PJayChen/Crazyflies/4x_app_crazyflie_rel_a/release_note.JPG

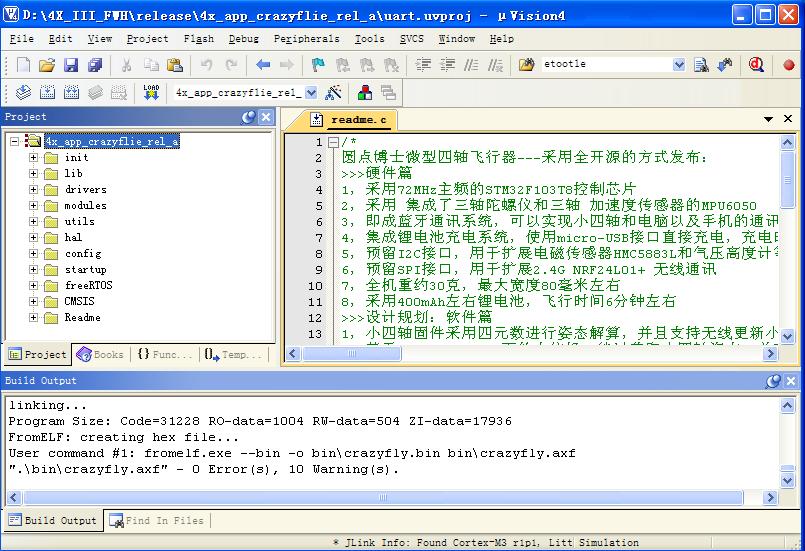
4x_app_crazyflie_rel_a/release_note.JPG
