PJayChen/Crazyflies/4x_menue_v30.pdf

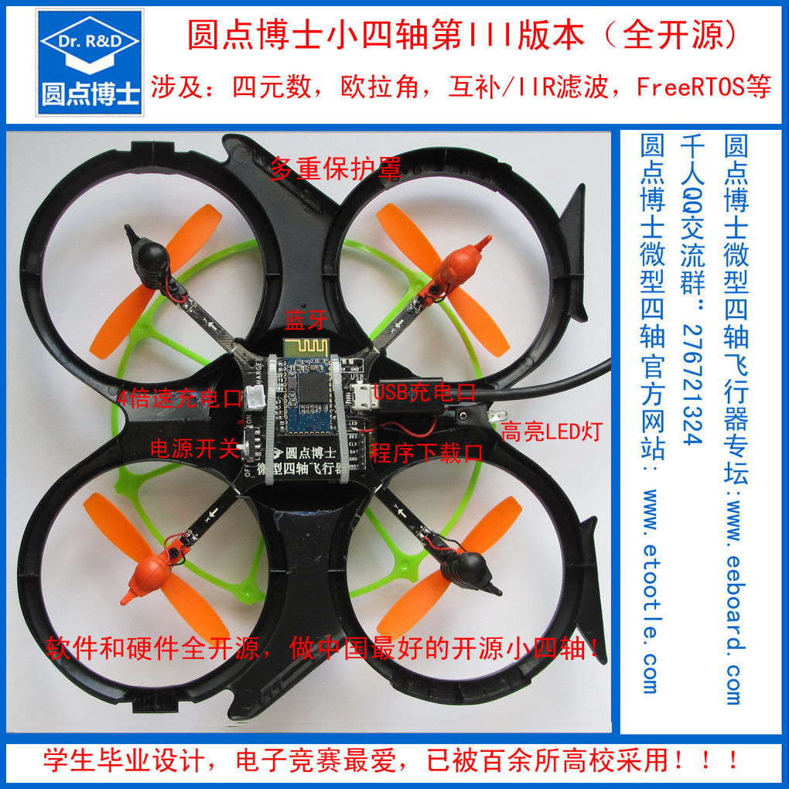
[picture p2: figure]

圆点博士微型四轴飞行器 www.etootle.com

## 圆点博士微型四轴飞行器第III版本使用手册

初版3.11
2013年8月14日发布

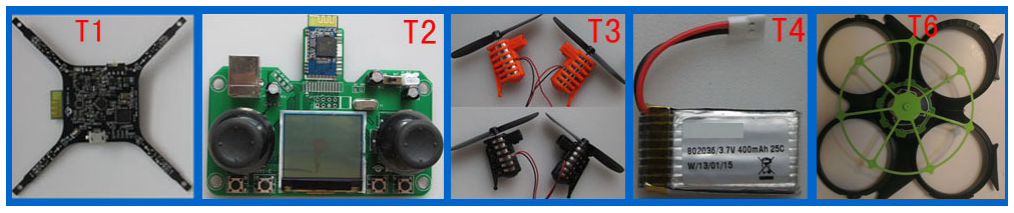
[picture p3: figure]

圆点博士微型四轴飞行器 www.etootle.com

圆点博士微型四轴飞行器第III版：

>>>硬件篇
1，采用了72MHz主频的STM32F103T8控制芯片 2，采用了三轴陀螺仪和三轴加速度传感器的MPU6050 3，集成蓝牙通讯系统，可以实现小四轴和电脑/手机的通讯 4，集成锂电池充电系统，可以使用micro-USB接口直接充电 5，预留电磁传感器HMC5883L芯片安装位置，方便用户进行扩展 6，预留I2C接口，用于扩展电磁传感器HMC5883L和高度计BMP085等模块 7，预留SPI接口，用于扩展2.4G NRF24L01+ 无线通讯模块 8，全机重约45克，对角电机中心点宽度120毫米左右 9，采用400mAh左右锂电池，飞行时间6分钟左右

>>>软件篇
1，小四轴固件采用四元数进行姿态解算的源码，支持无线更新固件 2，基于MPU6050 DMP的姿态解算源码
3，基于国外开源软件Crazyflie姿态解算源码的部分移植 4，基于windows/Linux下的上位机，能够控制小四轴飞行 5，基于Android的上位机，可以实现对小四轴的飞行控制 6，基于labview的部分上位机编程，实现波形显示

>>>开源说明：
1，PDF格式原理图和元器件列表
2，小四轴固件全部源码
3，PC上位机全部源码
4, Android的上位机全部源码

圆点博士微型四轴飞行器 www.etootle.com

目录：

第I部分：小四轴
第1.1节：圆点博士微型四轴飞行器的蓝牙连接
第1.2节：圆点博士微型四轴飞行器电机的组装
第1.3节：圆点博士微型四轴飞行器电池的组装
第1.4节：圆点博士微型四轴飞行器的外部模块(HMC5883L/BMP085)连接 第1.5节：圆点博士微型四轴飞行器飞行测试
第1.6节：圆点博士微型四轴飞行器固件更新
第1.7节：圆点博士微型四轴飞行器PID调节方法
第1.8节：圆点博士微型四轴飞行器使用注意事项

第II部分：手持遥控器
第2.1节：圆点博士微型四轴飞行器手持遥控器电源选择开关 第2.2节：圆点博士微型四轴飞行器手持遥控器固件更新 第2.3节：圆点博士微型四轴飞行器手持遥控器连接小四轴

第III部分：源码编译环境和说明
请参考视频教程

第IV部分：飞行理论
请参看论文部分

第V部分：附录
附录1：圆点博士微型四轴飞行器电路图
附录2：圆点博士微型四轴手持遥控器电路图
附录3：圆点博士微型四轴第III版元器件列表
附录4：圆点博士微型四轴蓝牙模块指令说明
附录5：圆点博士资料链接和版权声明

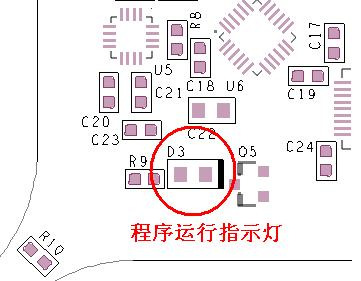
[picture p4: figure]
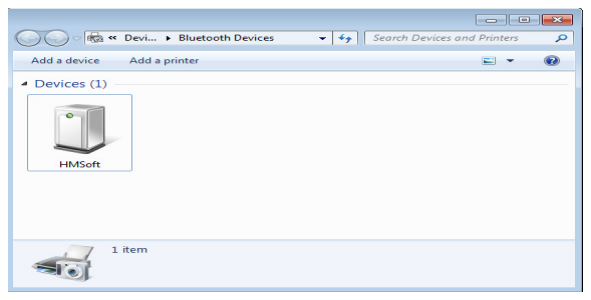
[picture p5: figure]
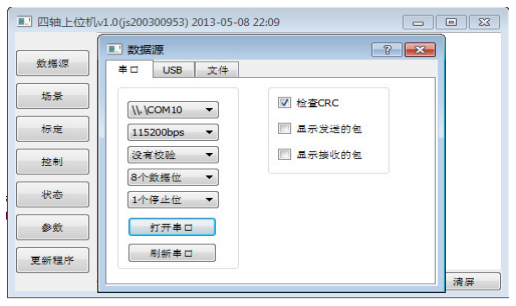
[picture p6: figure]
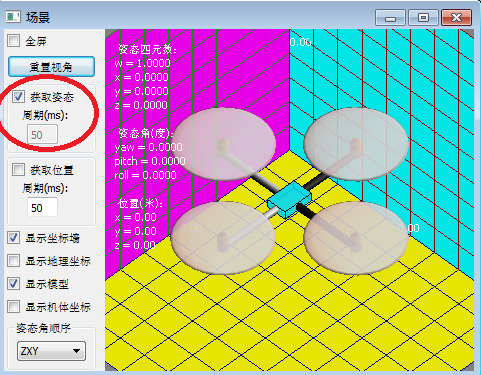
[picture p7: figure]

圆点博士微型四轴飞行器 www.etootle.com

第1.1节：圆点博士微型四轴飞行器的蓝牙连接

蓝牙连接步骤：
1， 打开小四轴的开关，此时小
四轴上的程序运行指示灯会
以每秒一次的速度进行闪
烁。
2， 打开PC的蓝牙开关，并添加
新的蓝牙设备。蓝牙配置密
码是数字“1234”
3， 配对成功后，连接蓝牙，并
找到蓝牙的映射端口
4， 打开小四轴上位机，选择数
据源，并选择对应的COM口
（也可手动输入COM口）.
5， 打开COM口成功后，即可以在
状态栏查看锂电池电压，和
在场景栏看到小四轴姿势。

注意：
1．进行该测试的时候，用户也可以
不装锂电池，而仅仅通过USB线给小
四轴通电。

2．在场景测试下，即使小四轴静止
不动，可能也能观察到小四轴的缓慢
围绕轴心转动。这是由于yaw的飘动
引起的，属于正常现象。对陀螺仪进
行校正可以缩小yaw的偏移。

### 3. 当使用蓝牙把小四轴连接到PC蓝

牙的时候，注意不要用电池等物品遮
挡住小四轴上的蓝牙天线，也不要把
身体或者其它物品放置在PC蓝牙天线
发射点和小四轴之间，否则会引起蓝
牙信号不佳的问题。

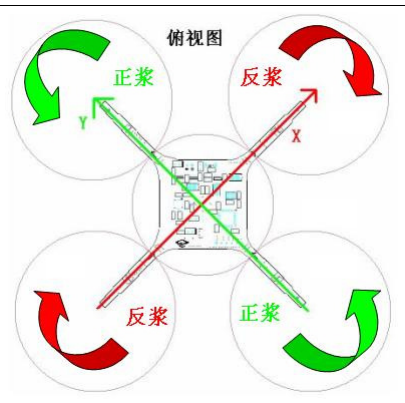
[picture p8: figure]
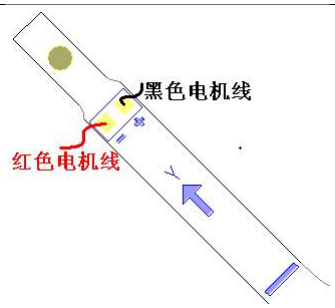
[picture p9: figure]
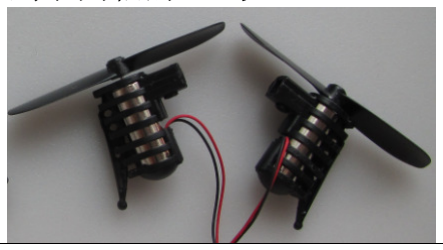
[picture p10: figure]
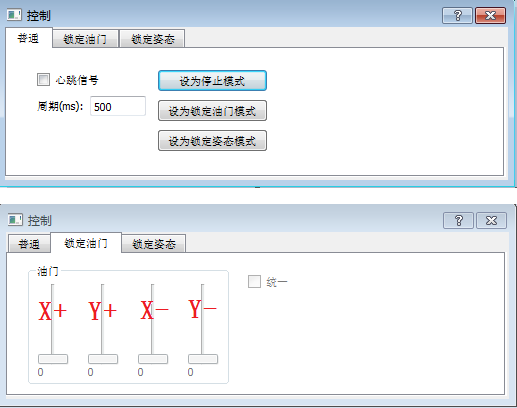
[picture p11: figure]

圆点博士微型四轴飞行器 www.etootle.com

第1.2节：圆点博士微型四轴飞行器电机的组装（只有T1套件需要进行电 机组装，对于T1+T3套件，电机已经组装好，用户无需自行组装）：

步骤一：选定电机位置 电机浆分为正浆和反浆。在俯视情 况下，顺时针旋转浆，如果浆是从 低平面向高平面方向旋转，则为反 浆；如果浆是从高平面向低平面方 向旋转，则为正浆。

步骤二：焊接电机线 把所搭配的电机的红色电线连接到 小四轴的”-”号上，黑色电线连接 到小四轴的”+”号上。

步骤三：测试电机 1． 打开上位机 2． 设置为锁定油门模式 3． 用鼠标拉动油门值 测试中，请检查是否每个电机都是 朝地面吹风。如果发生朝上面吹风 的现象，请检查浆的安装，或者电 机电线的焊接。四个油门分别对应 小四轴上X+, Y+, X-, Y-的电机。 注：上述测试需要在小四轴和上位 机已经连接的情况下进行，并且需 要安装上电池。

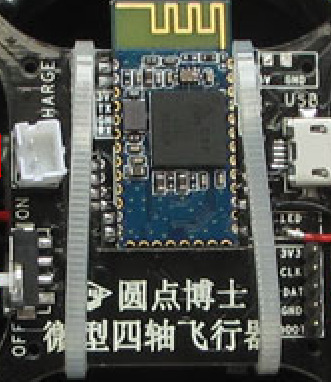
[picture p12: figure]
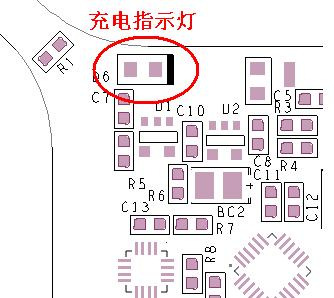
[picture p13: figure]

圆点博士微型四轴飞行器 www.etootle.com

第1.3节：圆点博士微型四轴飞行器电池的组装：

组装步骤：
1． 用双面贴固定电池
并安装到正面。
2． 捆上塑料条固定整
个电池，建议按照
图示方向安装塑料
条。
3． 连接电池接口，红
线和红线连接。小
四轴上有防反插接
口，请勿反插电
池。
4． 注意：请勿让电池
阻挡蓝牙天线

小四轴已经集成锂电池充电
系统。把USB头通过USB线连
接到电脑的USB口，或者带
USB口的电源适配器，小四轴
即开始对锂电池进行充电。
1． 充电过程中，充电
指示灯会亮起，充
电完成后，指示灯
会熄灭。
2． 如果充电指示灯以
微弱的亮度在闪
烁，则表明锂电池
没有连接好。
3． 开关的打开或者闭
合不影响充电过
程。

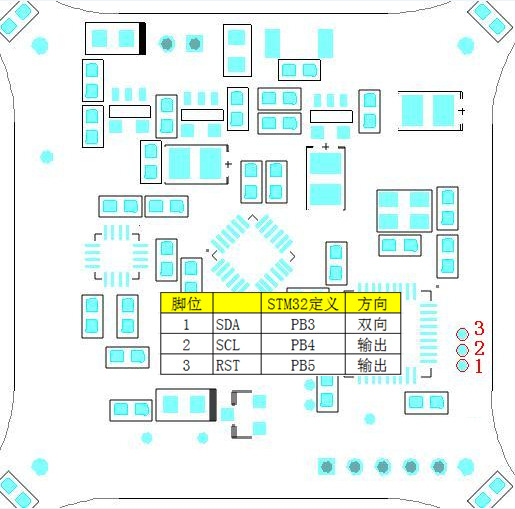
[picture p14: figure]

圆点博士微型四轴飞行器 www.etootle.com

第1.4节：圆点博士微型四轴飞行器的外部模块连接（可选，仅针对有需 要的用户）。

外接I2C接口, 可以用作普通I2C接口或者普通GPIO。用户可以通过该接口 连接磁场传感器HMC5883L模块和气压计模块BMP085。 注意：当连接I2C模块时，用户需要确保模块的SDA引脚上有上拉电阻。

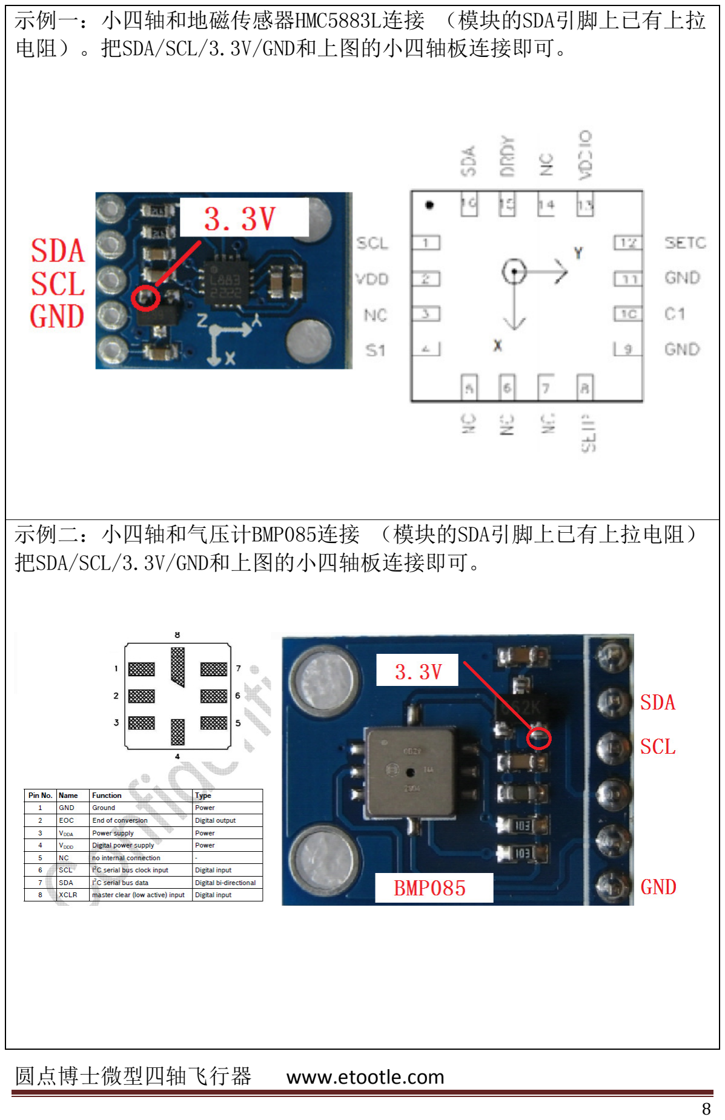
[picture p15: page 8]

圆点博士微型四轴飞行器 www.etootle.com

示例一：小四轴和地磁传感器HMC5883L连接 （模块的SDA引脚上已有上拉 电阻）。把SDA/SCL/3.3V/GND和上图的小四轴板连接即可。

示例二：小四轴和气压计BMP085连接 （模块的SDA引脚上已有上拉电阻） 把SDA/SCL/3.3V/GND和上图的小四轴板连接即可。

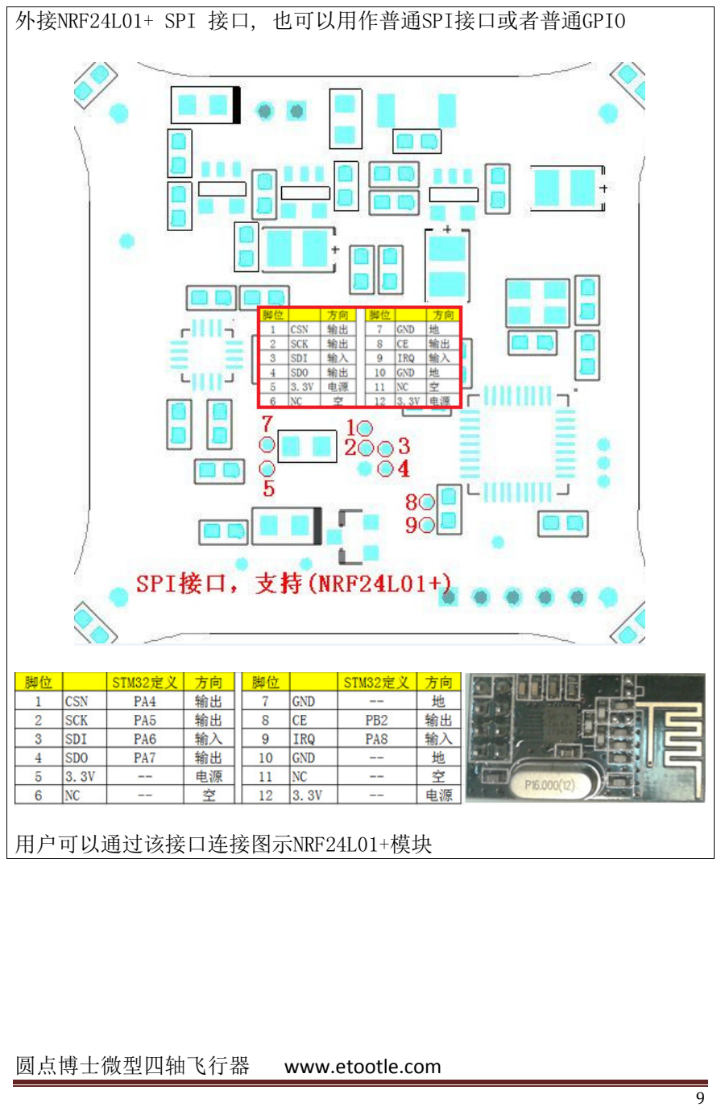
[picture p16: page 9]

圆点博士微型四轴飞行器 www.etootle.com

外接NRF24L01+ SPI 接口, 也可以用作普通SPI接口或者普通GPIO

用户可以通过该接口连接图示NRF24L01+模块

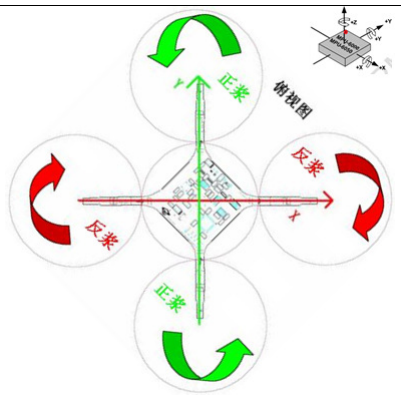
[picture p17: figure]
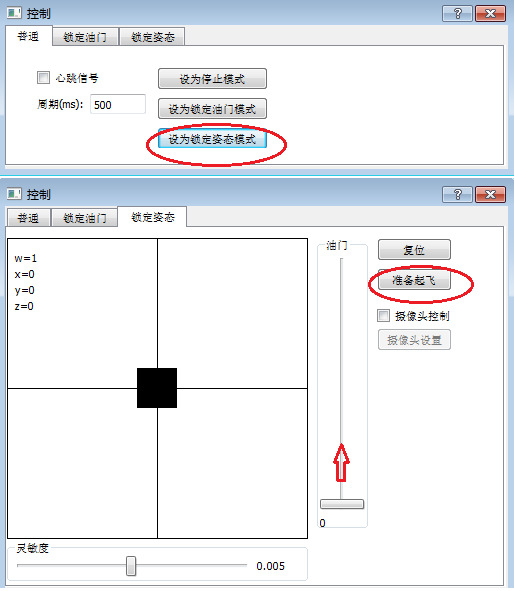
[picture p18: figure]
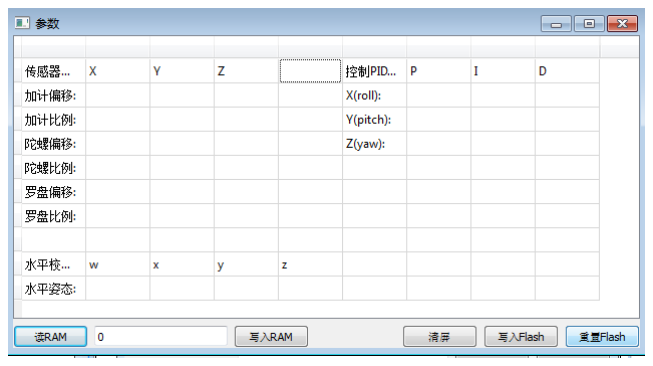
[picture p19: figure]

圆点博士微型四轴飞行器 www.etootle.com

第1.5节：圆点博士微型四轴飞行器飞行测试

1， 把小四轴按照左图所示方向
放置，以对应于上位机的方
向控制。
2， 在上位机设置模式为“锁定
姿势模式”。
3， 在姿势界面点击“准备起
飞”。
4， 轻轻拉动油门。
5， 根据小四轴起飞后的偏移方
向微调小黑块位置，反复调
试，即可获得较佳的起飞角
度。
6， 小四轴起飞后，可通过调整
小黑块来实现飞行方向的控
制
7， 用户也可以通过调整PID参数
来获得更好的飞行和悬浮稳
定性。

注意：小四轴代码集成了电机保护和
电池保护功能：
1． 如果小四轴机身倾斜超过一
定角度，电机会被锁死。此
时，用户需要到“控制界
面”重新设定模式为锁定姿
势模式”。
2． 如果电池电压过低，电机也
会停止运转，此时用户应该
对电池进行充电。

当用户发现电机无法转动的时候，请
根据上位机主界面的提示排除上述情
况。

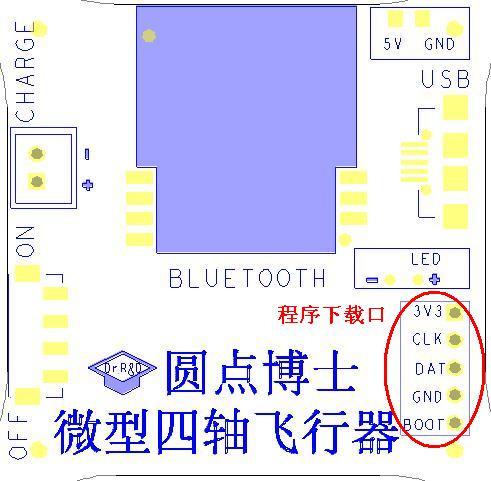
[picture p20: figure]

圆点博士微型四轴飞行器 www.etootle.com

第1.6节：圆点博士微型四轴飞行器固件更新

警告：在使用SWD下载的时候，请勿把3.3V
和GND反接。反接会引起小四轴的永久损
坏。如非必要，请勿使用SWD方式下载固
件。

小四轴在出厂前已经预装好
固件。用户可以通过上位机
以无线的方式来更新固件。

注意：如果你对STM32 SWD不
熟悉，请勿匆忙使用该接口
下载固件。建议总是通过上
位机以无线的方式更新固
件。

当一个不正确的固件被通过
上位机以无线的方式更新到
小四轴后，可能到导致你无
法再通过上位机无线更新固
件。在这种情况下，请使用
镊子或者电线短接左图中的
BOOT脚和GND脚，然后给小四
轴上电。此时小四轴将会一
直停留在bootloader状态，
等待用户从上位机通过无线
更新固件。当小四停留在
Bootloader状态下时，只有
更新固件部分可以使用，其
它姿态和电压显示等均无法
使用。当完成固件更新后，
如果小四上的LED灯不闪烁，
建议给小四重新上电，即先
关闭开关，然后再打开开
关。

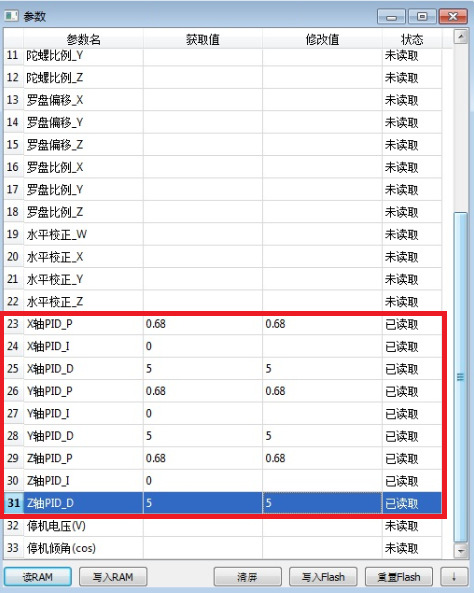
[picture p21: figure]
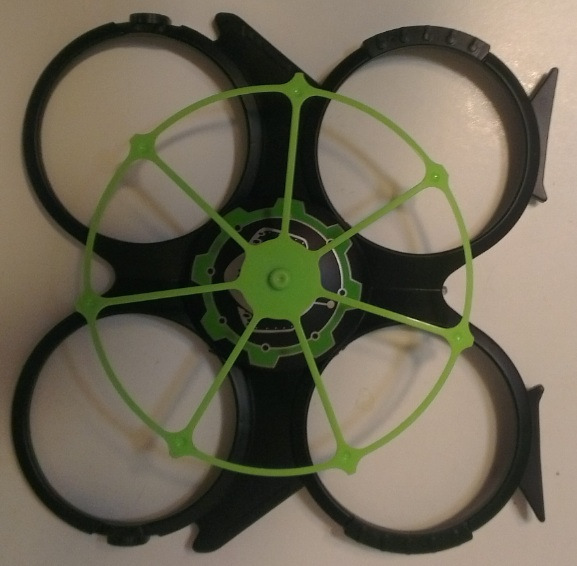
[picture p22: figure]

圆点博士微型四轴飞行器 www.etootle.com

第1.7节：圆点博士微型四轴飞行器PID调节方法
为了获取最佳的飞行参
数，用户可能需要自行
调整小四轴的PID参数。
用户可以根据下面的步
骤方便地进行小四轴的
PID参数调节：

第一步：连接小四轴和
上位机

第二步： 点击“读RAM”
获取小四轴当前的PID参
数

第三步：在“修改值”
栏填入新的PID参数

第四步：点击“写入
RAM”把参数写入小四轴

第五步：到上位机的控
制界面进行飞行测试

第六步：反复上述步
骤，直至找到合适的PID
参数为止。

第七步：点击“写入
Flash”把上述参数写入
小四轴的Flash.

注意：在PID参数的调节
过程中，要注意保护好
小四轴，避免摔坏。可
参考左图给小四轴进行
保护。

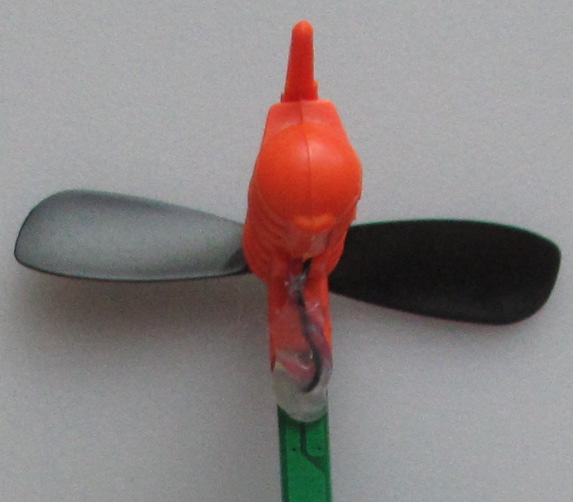
[picture p23: figure]

圆点博士微型四轴飞行器 www.etootle.com

第1.8节：圆点博士微型四轴飞行器使用注意事项

1．注意避免小四轴以左图的方式掉到地
上。 巨大的冲击力可能会把电机后盖顶
开，导致电机损坏。建议在小四正面固定
合适的泡沫，用于保护电机。

2， 每次起飞前，检查电机。如果电机后
盖已经脱落，请勿继续飞行。损坏的电机
可能会导致驱动电路损坏，并起火。

注意：用户需要要小心使用并熟悉套件 。
电机是最容易损坏的部件，请务必小心。

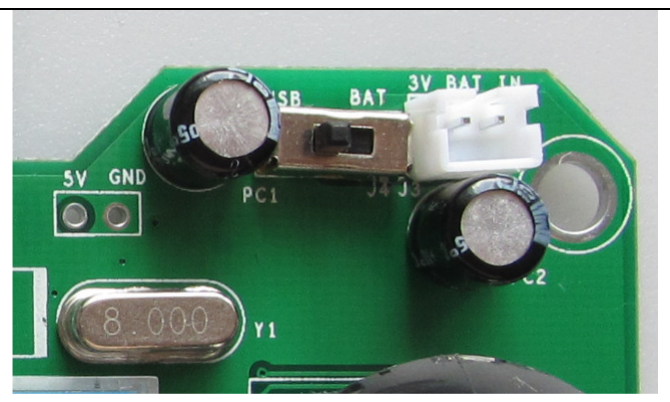
[picture p24: figure]
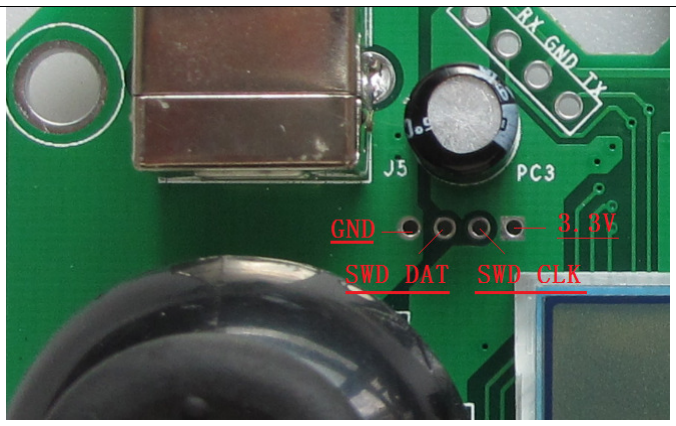
[picture p25: figure]

圆点博士微型四轴飞行器 www.etootle.com

第2.1节：圆点博士微型四轴飞行器手持遥控器电源选择开关

1． 当使用USB供电的时候，需要把开
关拨至”USB”位置。
2． 当使用干电池供电的时候，需要把
开关拨至“BAT”位置。

注意：当使用电池供电的时候，电池输入必
须是3V到3.3V。用户可使用2节干电池串
连。请勿直接使用锂电池提供电源，因为锂
电池的电压是3.7V到4.2V，该电压可能会损
坏该手持遥控器。

第2.2节：圆点博士微型四轴飞行器手持遥控器固件更新

遥控器在出厂前已经预
装好固件。目前，遥控
器并不支持通过上位机
更新固件，只能使用
SWD来进行固件更新。

警告：在使用SWD下载
的时候，请勿把3.3V和
GND反接。反接会引起
遥控器的永久损坏。

第2.3节：圆点博士微型四轴飞行器手持遥控器连接小四轴

给小四轴和手持上电，进入手持的飞行菜单，看是否能看到小四轴上 的电压值，如能看到，则表明连接成功，如不能，请执行下面步骤： 第一步：进入手持遥控器的蓝牙菜单
第二步：选择“Clear”清除
第三步：重新给手持遥控器上电，手持即开始自动寻找并连接小四轴。

注意：由于小四轴的蓝牙同一时间只能和一个蓝牙主设备连接，当进行手 持遥控器连接时，必须断开小四轴和PC蓝牙的连接。

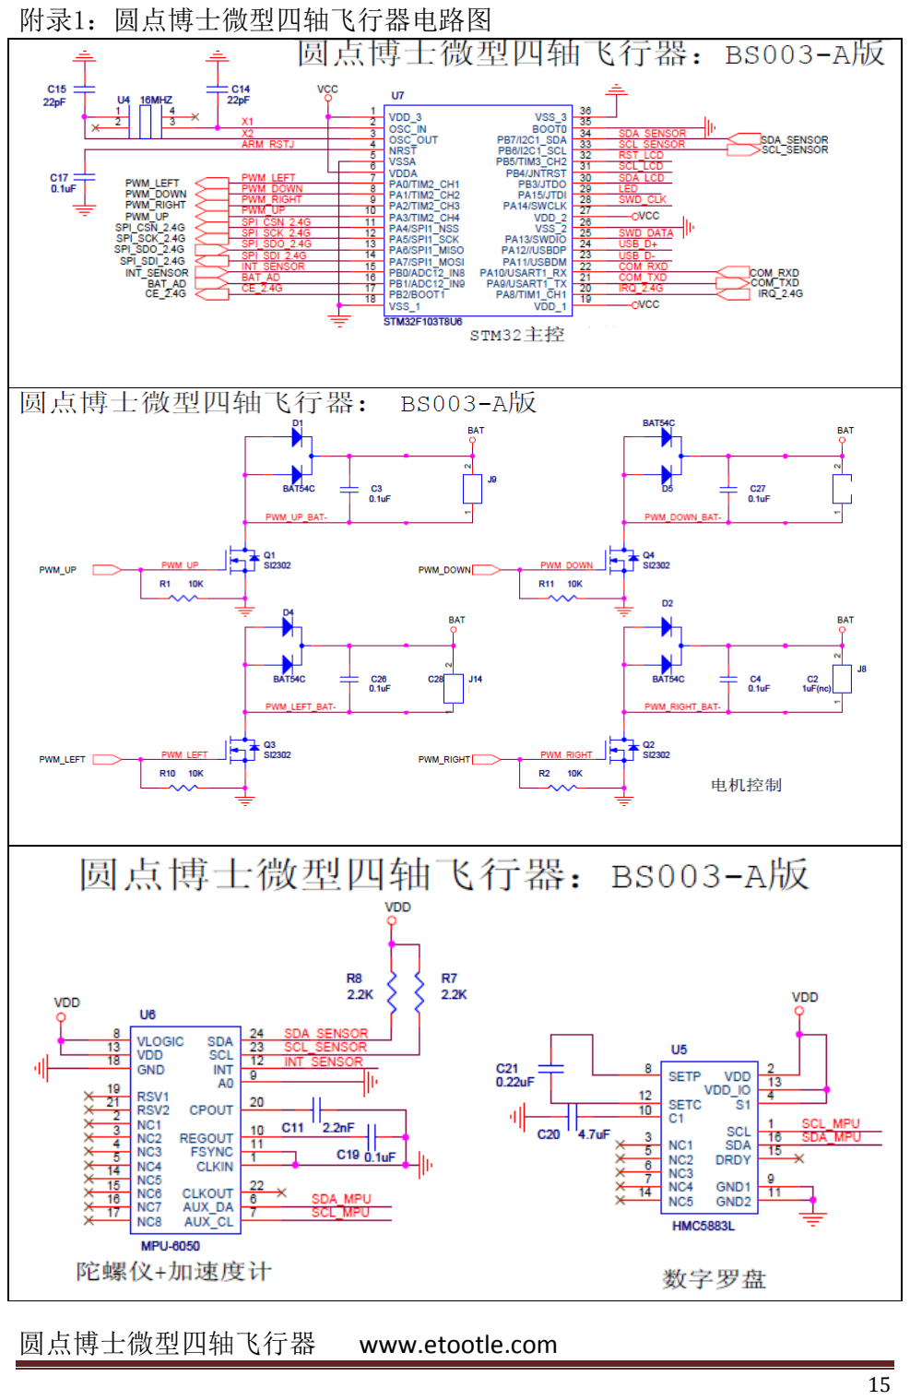
[picture p26: page 15]

圆点博士微型四轴飞行器 www.etootle.com

附录1：圆点博士微型四轴飞行器电路图

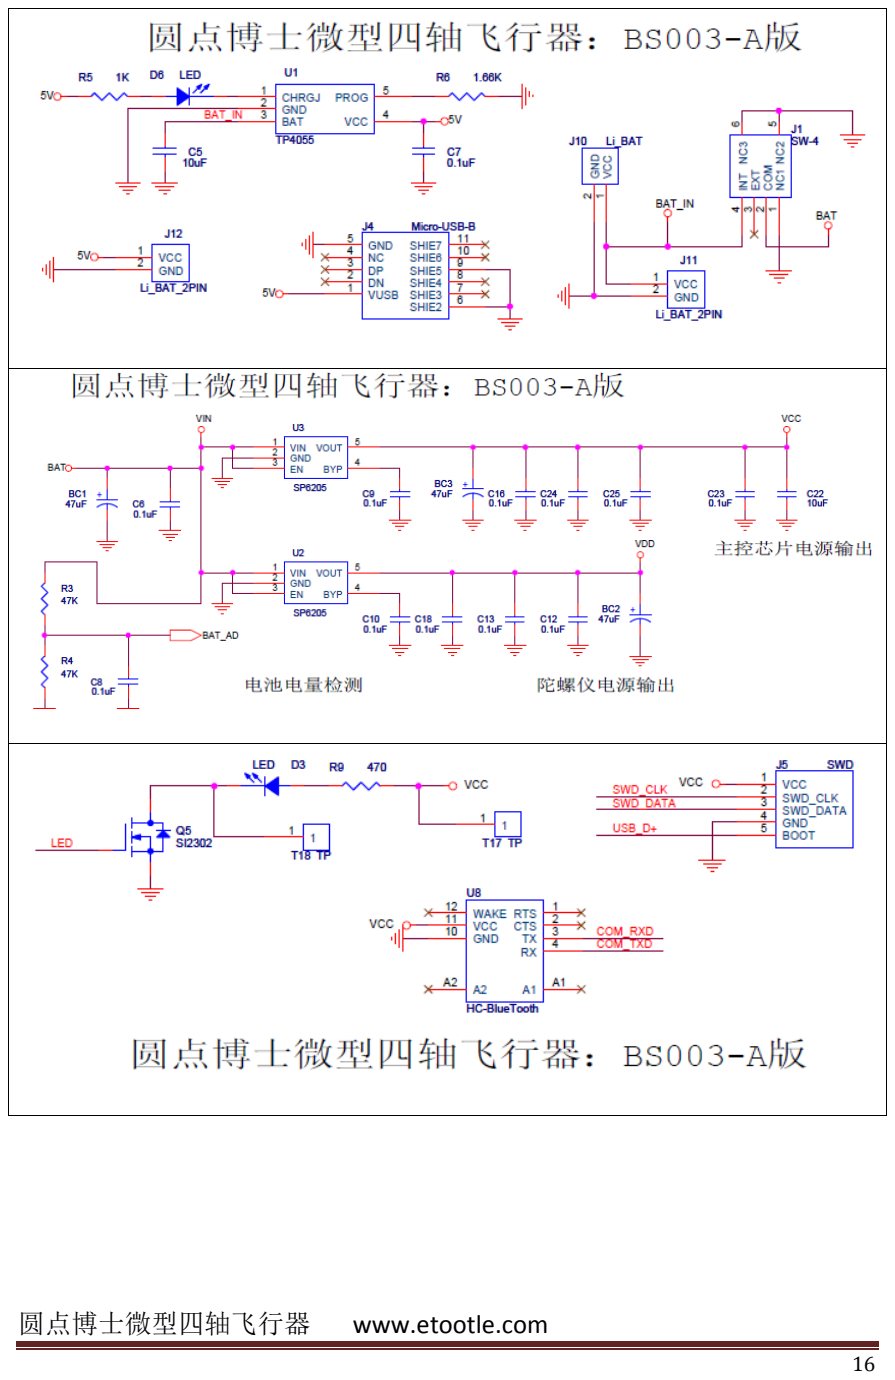
[picture p27: page 16]

圆点博士微型四轴飞行器 www.etootle.com

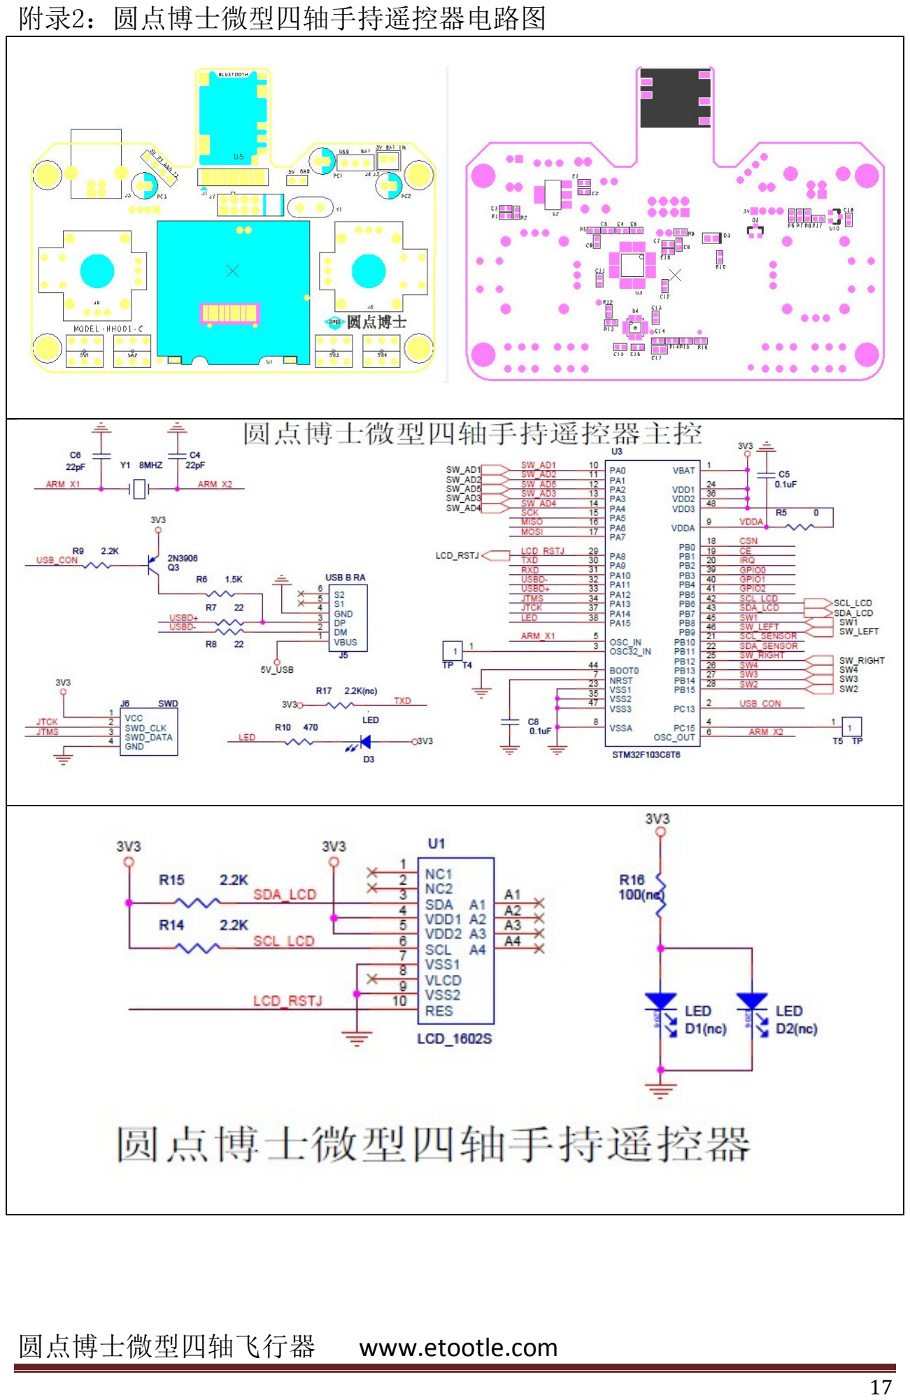
[picture p28: page 17]

圆点博士微型四轴飞行器 www.etootle.com

附录2：圆点博士微型四轴手持遥控器电路图

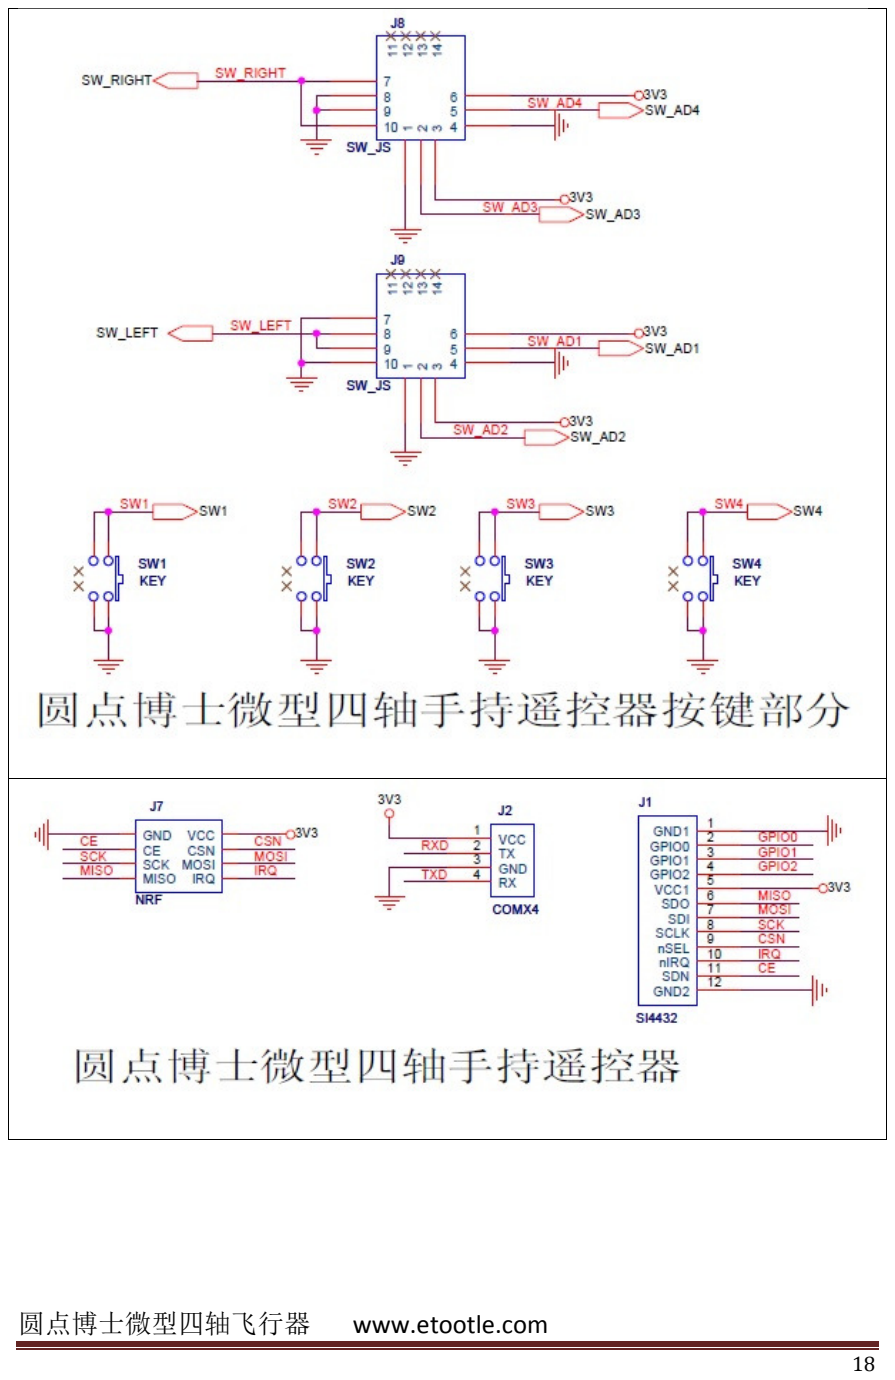
[picture p29: page 18]

圆点博士微型四轴飞行器 www.etootle.com

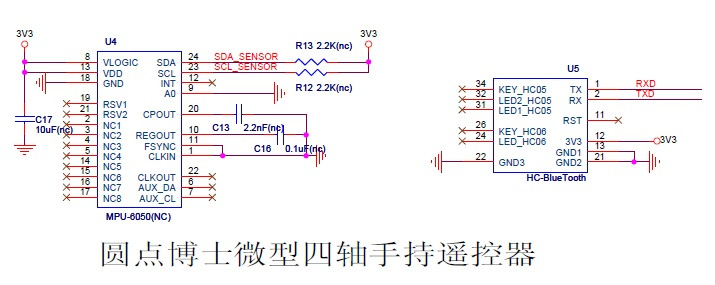
[picture p30: figure]
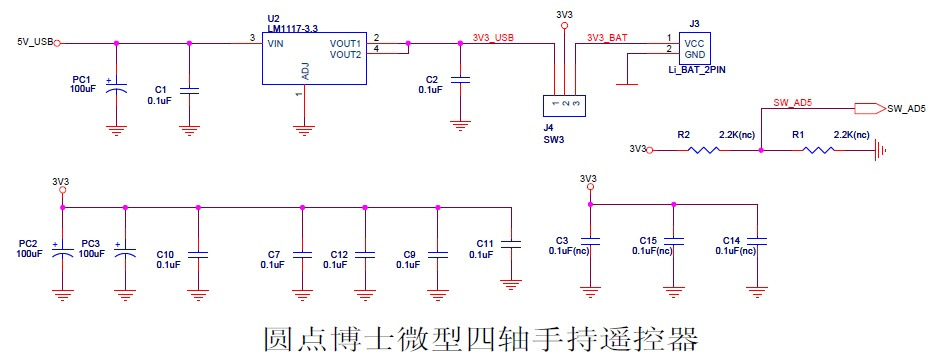
[picture p31: figure]

圆点博士微型四轴飞行器 www.etootle.com

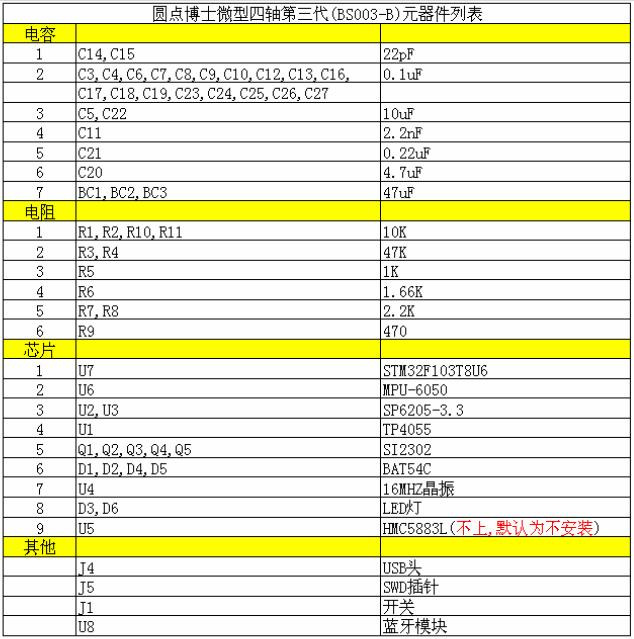
[picture p32: figure]

圆点博士微型四轴飞行器 www.etootle.com

附录3：圆点博士微型四轴第III版元器件列表

圆点博士微型四轴飞行器 www.etootle.com

附录4：圆点博士微型四轴蓝牙模块指令说明

功能 | 指令 | 应答 | 参数和注释
设置主从模式 | AT+ROLE[par] | OK+Set:[par] | Par：M(主)或S(从)
设置配对密码 | AT+PIN[par] | OK+Set:[par] | Par：密码(默认：1234)
清除配对信息 | AT+CLEAR | OK+CLEAR | 清除上次连接的设备
搜索并连接从设备 | AT+SEARCH | OK | 连接新的设备
连接原来的从设备 | AT+CONLAST | OK | 连接上一次连接过的设备
连接指定的从设备 | AT+CONN[par] | OK | Par：蓝牙地址码
设置尝试连接时间 | AT+TCON[par] | OK+Set:[par] | Par:0000-9999(0表示持续)
查询本机MAC地址 | AT+LADD? | OK+LADD: 地址 | 无
设置上电模式 | AT+IMME[par] | OK+Set:[par] | Par：0(等待) 或1(工作)
进入工作模式 | AT+WORK | OK+WORK | 当上电模式为等待时适用
复位模块 | AT+RESTART | OK+RESTART | 无
恢复默认设置 | AT+DEFAULT | OK+DEFAULT | 无
设置设备名称 | AT+NAME[par] | OK+Set[par] | Par：设备名称
设置波特率 | AT+BAUD[par] | OK+Set:[波特率] | Par:1-C 对应:1200-1382400
查询波特率 | AT+BAUD? | OK+BAUD:[par] | Par: 波特率
设置串口校验 | AT+CHK[par | OK+Set:[par] | Par:0(无), 1(ODD), 2(ENEN)
设置停止位宽度 | AT+STOP[par] | OK+Set:[par] | Par:1(一位), 2(两位),
通讯测试 | AT | OK | 无
系统帮助 | AT+HELP? | 帮助信息 | 无

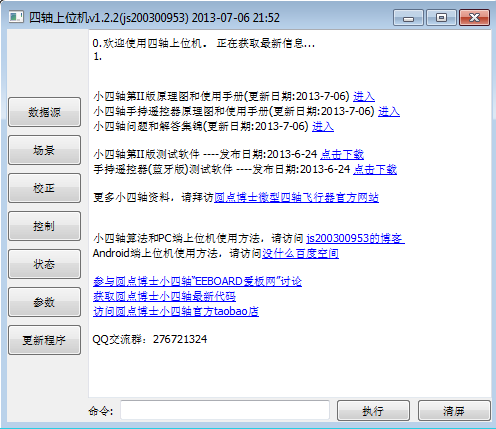
[picture p33: figure]

圆点博士微型四轴飞行器 www.etootle.com

附录5：圆点博士资料链接和版权声明

# 请总是通过打开“PC上位机软件”获取最新的源码和资料 ”获取最新的源码和资料。要获得这些更新信息 。要获得这些更新信息，需 要在有网络连接的情况下打开“PC上位机软件”。

请拜访圆点博士微型四轴飞行器官方网站获得上位机软件： http://www.etootle.com/product/flight-kit.html

请拜访圆点博士微型四轴飞行器专坛查看常见问题和解决方法： http://www.eeboard.com/bbs/forum-98-1.html

欢迎加入圆点博士微型四轴飞行器QQ讨论群（群号：276721324） 参与小 四轴技术讨论。

圆点博士微型四轴飞行器 www.etootle.com

圆点博士微四轴飞行器版权和声明 圆点博士微四轴飞行器版权和声明

感谢大家阅读该使用手册：
圆点博士微型四轴飞行器使用手册仅为使用者提供参考，而圆点博 士不对该使用手册提供任何明示或暗含的担保。圆点博士不对在使用该使 用手册中可 能出现的意外或者损失负责，也不对因使用该使用手册而引 起的第三方索赔负 责。该使用手册内容有可能会被随时变更，相关信息 的更新恕不另行通知。
该使用手册仅以学习的形式发布，并受版权保护, 未经书面授权, 请勿以商业的目的使用或者修改该使用手册。圆点博士对该使用手保留最 终解释权。

该使用手册和相关的文件在官网提供下栽，请随时拜访官网 www.etootle.com获得最新的版本．
