PJayChen/Crazyflies/4x_app_crazyflie_rel_a/init/main.c

/**
 *    ||          ____  _ __                           
 * +------+      / __ )(_) /_______________ _____  ___ 
 * | 0xBC |     / __  / / __/ ___/ ___/ __ `/_  / / _ \
 * +------+    / /_/ / / /_/ /__/ /  / /_/ / / /_/  __/
 *  ||  ||    /_____/_/\__/\___/_/   \__,_/ /___/\___/
 *
 * Crazyflie control firmware
 *
 * Copyright (C) 2011-2012 Bitcraze AB
 *
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
 * main.c - Containing the main function.
 */

/* Personal configs */
#include "FreeRTOSConfig.h"

/* FreeRtos includes */
#include "FreeRTOS.h"
#include "task.h"

/* Project includes */
#include "config.h"
#include "system.h"
#include "nvic.h"

#include "led.h"

/* ST includes */
#include "stm32f10x.h"

/* Private functions */
static void prvClockInit(void);

int main() 
{
  //Low level init: Clock and Interrupt controller
  prvClockInit();
	
  nvicInit();

  //Launch the system task that will initialize and start everything
  systemLaunch();

  //Start the FreeRTOS scheduler
  vTaskStartScheduler();

  //Should never reach this point!
  while(1);

 // return 0;
}

//Clock configuration
static void prvClockInit(void)
{
  ErrorStatus HSEStartUpStatus;

  RCC_DeInit();
  /* Enable HSE */
  RCC_HSEConfig(RCC_HSE_ON);
  /* Wait till HSE is ready */
  HSEStartUpStatus = RCC_WaitForHSEStartUp();

	if (HSEStartUpStatus == SUCCESS)
  {
    /* Enable Prefetch Buffer */
    FLASH_PrefetchBufferCmd(FLASH_PrefetchBuffer_Enable);

    /* Flash 2 wait state */
    FLASH_SetLatency(FLASH_Latency_2);

    /* HCLK = SYSCLK */
    RCC_HCLKConfig(RCC_SYSCLK_Div1);

    /* PCLK2 = HCLK */
    RCC_PCLK2Config(RCC_HCLK_Div1);

    /* PCLK1 = HCLK/2 */
    RCC_PCLK1Config(RCC_HCLK_Div2);

    /* ADCCLK = PCLK2/6 = 72 / 6 = 12 MHz*/
    RCC_ADCCLKConfig(RCC_PCLK2_Div6);

    /* PLLCLK = 16MHz/2 * 9 = 72 MHz */
    RCC_PLLConfig(RCC_PLLSource_HSE_Div2, RCC_PLLMul_9);

    /* Enable PLL */
    RCC_PLLCmd(ENABLE);

    /* Wait till PLL is ready */
    while (RCC_GetFlagStatus(RCC_FLAG_PLLRDY) == RESET);

    /* Select PLL as system clock source */
    RCC_SYSCLKConfig(RCC_SYSCLKSource_PLLCLK);

    /* Wait till PLL is used as system clock source */
    while(RCC_GetSYSCLKSource() != 0x08);
  } else {
      GPIO_InitTypeDef GPIO_InitStructure;
  
    //Cannot start the main oscillator: red/green LED of death...
    GPIO_InitStructure.GPIO_Pin = LED_GPIO_RED | LED_GPIO_GREEN;
    GPIO_InitStructure.GPIO_Mode = GPIO_Mode_Out_PP;
    GPIO_InitStructure.GPIO_Speed = GPIO_Speed_10MHz;

    GPIO_Init(GPIOA, &GPIO_InitStructure);
    
    GPIO_ResetBits(GPIOA, LED_RED);
    GPIO_ResetBits(GPIOA, LED_GREEN);

    //Cannot start xtal oscillator!
    while(1); 
  }
}
