PJayChen/Crazyflies/4x_app_crazyflie_rel_a/drivers/interface/motors.h

/**
 *    ||          ____  _ __                           
 * +------+      / __ )(_) /_______________ _____  ___ 
 * | 0xBC |     / __  / / __/ ___/ ___/ __ `/_  / / _ \
 * +------+    / /_/ / / /_/ /__/ /  / /_/ / / /_/  __/
 *  ||  ||    /_____/_/\__/\___/_/   \__,_/ /___/\___/
 *
 * Crazyflie control firmware
 *
 * Copyright (C) 2011-2012 Bitcraze AB
 *
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
 * Motors.h - Motor driver header file
 *
 * The motors PWM ratio is a value on 16 bits (from 0 to 0xFFFF)
 * the functions of the driver will make the conversions to the actual PWM
 * precision (ie. if the precision is 8bits 0xFFFF and 0xFF00 are equivalents).
 *
 * The precision is set in number of bits by the define MOTORS_PWM_BITS
 * The timer prescaler is set by MOTORS_PWM_PRESCALE
 */
#ifndef __MOTORS_H__
#define __MOTORS_H__

#include <stdint.h>
#include <stdbool.h>
#include "config.h"

/******** Defines ********/

//The following defines gives a PWM of 9 bits at ~140KHz for a sysclock of 72MHz
#define MOTORS_PWM_BITS     9
#define MOTORS_PWM_PERIOD   ((1<<MOTORS_PWM_BITS) - 1)
#define MOTORS_PWM_PRESCALE 0


// Motors IDs define
#define MOTOR_M1  0
#define MOTOR_M2  1
#define MOTOR_M3  2
#define MOTOR_M4  3

// Test defines
#define MOTORS_TEST_RATIO         (uint16_t)(0.5*(1<<16))
#define MOTORS_TEST_ON_TIME_MS    10
#define MOTORS_TEST_DELAY_TIME_MS 50

/*** Public interface ***/

/**
 * Initialisation. Will set all motors ratio to 0%
 */
void motorsInit(void);

/**
 * Test of the motor modules. The test will spin each motor very short in
 * the sequence M1 to M4.
 */
bool motorsTest(void);

/**
 * Set the PWM ratio of the motor 'id'
 */
void motorsSetRatio(int id, uint16_t ratio);

/**
 * Get the PWM ratio of the motor 'id'. Return -1 if wrong ID.
 */
int motorsGetRatio(int id);

/**
 * FreeRTOS Task to test the Motors driver
 */
void motorsTestTask(void* params);

#endif /* __MOTORS_H__ */
