PJayChen/Crazyflies/4x_app_crazyflie_rel_a/modules/src/pidctrl.c

/**
 *    ||          ____  _ __                           
 * +------+      / __ )(_) /_______________ _____  ___ 
 * | 0xBC |     / __  / / __/ ___/ ___/ __ `/_  / / _ \
 * +------+    / /_/ / / /_/ /__/ /  / /_/ / / /_/  __/
 *  ||  ||    /_____/_/\__/\___/_/   \__,_/ /___/\___/
 *
 * Crazyflie control firmware
 *
 * Copyright (C) 2011-2012 Bitcraze AB
 *
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
 * pidctrl.c - Used to receive/answer requests from client and to receive updated PID values from client
 */
 
/* FreeRtos includes */
#include "FreeRTOS.h"
#include "task.h"

#include "crtp.h"
#include "pidctrl.h"
#include "pid.h"

typedef enum {
  pidCtrlValues = 0x00,
} PIDCrtlNbr;

void pidCrtlTask(void *param);

void pidCtrlInit()
{
  xTaskCreate(pidCrtlTask, (const signed char *)"PIDCrtl",
              configMINIMAL_STACK_SIZE, NULL, /*priority*/2, NULL);
  crtpInitTaskQueue(CRTP_PORT_PIDCTRL);
}

void pidCrtlTask(void *param)
{
  CRTPPacket p;
  extern PidObject pidRollRate;
  extern PidObject pidPitchRate;
  extern PidObject pidYawRate;
  extern PidObject pidRoll;
  extern PidObject pidPitch;
  extern PidObject pidYaw;
  struct pidValues
  {
    uint16_t rateKpRP;
    uint16_t rateKiRP;
    uint16_t rateKdRP;
    uint16_t attKpRP;
    uint16_t attKiRP;
    uint16_t attKdRP;
    uint16_t rateKpY;
    uint16_t rateKiY;
    uint16_t rateKdY;
    uint16_t attKpY;
    uint16_t attKiY;
    uint16_t attKdY;
  }  __attribute__((packed));
  struct pidValues *pPid;

  while (1)
  {
    if (crtpReceivePacketBlock(CRTP_PORT_PIDCTRL, &p) == pdTRUE)
    {
      PIDCrtlNbr pidNbr = (PIDCrtlNbr)p.channel;
      
      switch (pidNbr)
      {
        case pidCtrlValues:
          pPid = (struct pidValues *)p.data;
          {
            pidSetKp(&pidRollRate, (float)pPid->rateKpRP/100.0);
            pidSetKi(&pidRollRate, (float)pPid->rateKiRP/100.0);
            pidSetKd(&pidRollRate, (float)pPid->rateKdRP/100.0);
            pidSetKp(&pidRoll, (float)pPid->attKpRP/100.0);
            pidSetKi(&pidRoll, (float)pPid->attKiRP/100.0);
            pidSetKd(&pidRoll, (float)pPid->attKdRP/100.0);
            pidSetKp(&pidPitchRate, (float)pPid->rateKpRP/100.0);
            pidSetKi(&pidPitchRate, (float)pPid->rateKiRP/100.0);
            pidSetKd(&pidPitchRate, (float)pPid->rateKdRP/100.0);
            pidSetKp(&pidPitch, (float)pPid->attKpRP/100.0);
            pidSetKi(&pidPitch, (float)pPid->attKiRP/100.0);
            pidSetKd(&pidPitch, (float)pPid->attKdRP/100.0);
            pidSetKp(&pidYawRate, (float)pPid->rateKpY/100.0);
            pidSetKi(&pidYawRate, (float)pPid->rateKiY/100.0);
            pidSetKd(&pidYawRate, (float)pPid->rateKdY/100.0);
            pidSetKp(&pidYaw, (float)pPid->attKpY/100.0);
            pidSetKi(&pidYaw, (float)pPid->attKiY/100.0);
            pidSetKd(&pidYaw, (float)pPid->attKdY/100.0);
          }
          break;
        default:
          break;
      } 
    }
  }
}
