PJayChen/Crazyflies/4x_app_crazyflie_rel_a/modules/src/pid.c

/**
 *    ||          ____  _ __                           
 * +------+      / __ )(_) /_______________ _____  ___ 
 * | 0xBC |     / __  / / __/ ___/ ___/ __ `/_  / / _ \
 * +------+    / /_/ / / /_/ /__/ /  / /_/ / / /_/  __/
 *  ||  ||    /_____/_/\__/\___/_/   \__,_/ /___/\___/
 *
 * Crazyflie control firmware
 *
 * Copyright (C) 2011-2012 Bitcraze AB
 *
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
 *
 * pid.c - implementation of the PID regulator
 */
#include "stm32f10x_conf.h"
#include <math.h>

#include "FreeRTOS.h"
#include "task.h"
#include "pid.h"
#include "imu.h"
#include "led.h"
#include "motors.h"

void pidInit(PidObject* pid, const float desired, const float kp,
             const float ki, const float kd)
{
  pid->error = 0;
  pid->prevError = 0;
  pid->integ = 0;
  pid->deriv = 0;
  pid->desired = desired;
  pid->kp = kp;
  pid->ki = ki;
  pid->kd = kd;
  
  pid->iLimit = DEFAULT_PID_INTEGRATION_LIMIT;
}

float pidUpdate(PidObject* pid, const float measured, const bool updateError)
{
  float output;

  if (updateError)
  {
    pid->error = pid->desired - measured;
  }

  pid->integ += pid->error * IMU_UPDATE_DT;
  if (pid->integ > pid->iLimit)
  {
    pid->integ = pid->iLimit;
  }
  else if (pid->integ < -pid->iLimit)
  {
    pid->integ = -pid->iLimit;
  }

  pid->deriv = (pid->error - pid->prevError) / IMU_UPDATE_DT;

  pid->outP = pid->kp * pid->error;
  pid->outI = pid->ki * pid->integ;
  pid->outD = pid->kd * pid->deriv;

  output = (pid->kp * pid->error) +
           (pid->ki * pid->integ) +
           (pid->kd * pid->deriv);

  pid->prevError = pid->error;

  return output;
}

void pidSetIntegralLimit(PidObject* pid, const float limit)
{
  pid->iLimit = limit;
}

void pidReset(PidObject* pid)
{
  pid->error = 0;
  pid->prevError = 0;
  pid->integ = 0;
  pid->deriv = 0;
}

void pidSetError(PidObject* pid, const float error)
{
  pid->error = error;
}

void pidSetDesired(PidObject* pid, const float desired)
{
  pid->desired = desired;
}

float pidGetDesired(PidObject* pid)
{
  return pid->desired;
}

bool pidIsActive(PidObject* pid)
{
  bool isActive = TRUE;

  if (pid->kp < 0.0001 && pid->ki < 0.0001 && pid->kd < 0.0001)
  {
    isActive = FALSE;
  }

  return isActive;
}

void pidSetKp(PidObject* pid, const float kp)
{
  pid->kp = kp;
}

void pidSetKi(PidObject* pid, const float ki)
{
  pid->ki = ki;
}

void pidSetKd(PidObject* pid, const float kd)
{
  pid->kd = kd;
}
