PJayChen/Crazyflies/4x_app_crazyflie_rel_a/modules/src/stabilizer.c

/**
 *    ||          ____  _ __
 * +------+      / __ )(_) /_______________ _____  ___
 * | 0xBC |     / __  / / __/ ___/ ___/ __ `/_  / / _ \
 * +------+    / /_/ / / /_/ /__/ /  / /_/ / / /_/  __/
 *  ||  ||    /_____/_/\__/\___/_/   \__,_/ /___/\___/
 *
 * Crazyflie Firmware
 *
 * Copyright (C) 2011-2012 Bitcraze AB
 *
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
 *
 */
#include "stm32f10x_conf.h"
#include "FreeRTOS.h"
#include "task.h"

#include "system.h"
#include "stabilizer.h"
#include "commander.h"
#include "controller.h"
#include "sensfusion6.h"
#include "imu.h"
#include "motors.h"
#include "log.h"

/**
 * Defines in what divided update rate should the attitude
 * control loop run relative the rate control loop.
 */
#define ATTITUDE_UPDATE_RATE_DIVIDER  2
#define FUSION_UPDATE_DT  (float)(1.0 / (IMU_UPDATE_FREQ / ATTITUDE_UPDATE_RATE_DIVIDER))

#define LOGGING_ENABLED
#ifdef LOGGING_ENABLED
  #define PRIVATE
#else
  #define PRIVATE static
#endif

PRIVATE Axis3f gyro; // Gyro axis data in deg/s
PRIVATE Axis3f acc;  // Accelerometer axis data in mG

PRIVATE float eulerRollActual;
PRIVATE float eulerPitchActual;
PRIVATE float eulerYawActual;
PRIVATE float eulerRollDesired;
PRIVATE float eulerPitchDesired;
PRIVATE float eulerYawDesired;
PRIVATE float rollRateDesired;
PRIVATE float pitchRateDesired;
PRIVATE float yawRateDesired;
PRIVATE float fusionDt;

RPYType rollType;
RPYType pitchType;
RPYType yawType;

uint16_t actuatorThrust;
int16_t  actuatorRoll;
int16_t  actuatorPitch;
int16_t  actuatorYaw;

uint32_t motorPowerM4;
uint32_t motorPowerM2;
uint32_t motorPowerM1;
uint32_t motorPowerM3;

/**********************************************************************************

LOG_GROUP_START(stabilizer)
LOG_ADD(LOG_FLOAT, roll, &eulerRollActual)
LOG_ADD(LOG_FLOAT, pitch, &eulerPitchActual)
LOG_ADD(LOG_FLOAT, yaw, &eulerYawActual)
LOG_ADD(LOG_UINT16, thrust, &actuatorThrust)
LOG_GROUP_STOP(stabilizer)

LOG_GROUP_START(motor)
LOG_ADD(LOG_INT32, m4, &motorPowerM4) 
LOG_ADD(LOG_INT32, m1, &motorPowerM1) 
LOG_ADD(LOG_INT32, m2, &motorPowerM2) 
LOG_ADD(LOG_INT32, m3, &motorPowerM3) 
LOG_GROUP_STOP(motor)

LOG_GROUP_START(acc)
LOG_ADD(LOG_FLOAT, x, &acc.x)
LOG_ADD(LOG_FLOAT, y, &acc.y)
LOG_ADD(LOG_FLOAT, z, &acc.z)
LOG_GROUP_STOP(acc)
**********************************************************************/

void logstabinit(logsvar *plogsint)
{
	plogsint->logs_stabilizer[0].type=LOG_GROUP | LOG_START;
	plogsint->logs_stabilizer[0].name="stabilizer";
	plogsint->logs_stabilizer[0].address=0x0;
	plogsint->logs_stabilizer[1].type=LOG_FLOAT;
	plogsint->logs_stabilizer[1].name="roll";
	plogsint->logs_stabilizer[1].address=&eulerRollActual;
	plogsint->logs_stabilizer[2].type=LOG_FLOAT;
	plogsint->logs_stabilizer[2].name="pitch";
	plogsint->logs_stabilizer[2].address=&eulerPitchActual;
	plogsint->logs_stabilizer[3].type=LOG_FLOAT;
	plogsint->logs_stabilizer[3].name="ywa";
	plogsint->logs_stabilizer[3].address=&eulerYawActual;
	plogsint->logs_stabilizer[4].type=LOG_UINT16;
	plogsint->logs_stabilizer[4].name="thrust";
	plogsint->logs_stabilizer[4].address=&actuatorThrust;
	plogsint->logs_stabilizer[5].type=LOG_GROUP | LOG_STOP;
	plogsint->logs_stabilizer[5].name="stop_stabilizer";
	plogsint->logs_stabilizer[5].address=0x0;
	
	plogsint->logs_motor[0].type=LOG_GROUP | LOG_START;
	plogsint->logs_motor[0].name="motor";
	plogsint->logs_motor[0].address=0x0;
	plogsint->logs_motor[1].type=LOG_INT32;
	plogsint->logs_motor[1].name="m4";
	plogsint->logs_motor[1].address=&motorPowerM4;
	plogsint->logs_motor[2].type=LOG_INT32;
	plogsint->logs_motor[2].name="m1";
	plogsint->logs_motor[2].address=&motorPowerM1;
	plogsint->logs_motor[3].type=LOG_INT32;
	plogsint->logs_motor[3].name="m2";
	plogsint->logs_motor[3].address=&motorPowerM2;
	plogsint->logs_motor[4].type=LOG_INT32;
	plogsint->logs_motor[4].name="m3";
	plogsint->logs_motor[4].address=&motorPowerM3;
	plogsint->logs_motor[5].type=LOG_GROUP | LOG_STOP;
	plogsint->logs_motor[5].name="stop_motor";
	plogsint->logs_motor[5].address=0x0;
	
	plogsint->logs_acc[0].type=LOG_GROUP | LOG_START;
	plogsint->logs_acc[0].name="acc";
	plogsint->logs_acc[0].address=0x0;
	plogsint->logs_acc[1].type=LOG_FLOAT;
	plogsint->logs_acc[1].name="x";
	plogsint->logs_acc[1].address=&acc.x;
	plogsint->logs_acc[2].type=LOG_FLOAT;
	plogsint->logs_acc[2].name="y";
	plogsint->logs_acc[2].address=&acc.y;
	plogsint->logs_acc[3].type=LOG_FLOAT;
	plogsint->logs_acc[3].name="z";
	plogsint->logs_acc[3].address=&acc.z;
	plogsint->logs_acc[4].type=LOG_GROUP | LOG_STOP;
	plogsint->logs_acc[4].name="stop_acc";
	plogsint->logs_acc[4].address=0x0;
}

static bool isInit;

static void distributePower(const uint16_t thrust, const int16_t roll,
                            const int16_t pitch, const int16_t yaw);
static uint16_t limitThrust(int32_t value);
static void stabilizerTask(void* param);

void stabilizerInit(void)
{
  if(isInit)
    return;

  motorsInit();
  imu6Init();
  sensfusion6Init();
  controllerInit();

  rollRateDesired = 0;
  pitchRateDesired = 0;
  yawRateDesired = 0;

  xTaskCreate(stabilizerTask, (const signed char *)"STABILIZER",
              2*configMINIMAL_STACK_SIZE, NULL, /*Piority*/2, NULL);

  isInit = TRUE;
}

bool stabilizerTest(void)
{
  bool pass = true;

  pass &= motorsTest();
  pass &= imu6Test();
  pass &= sensfusion6Test();
  pass &= controllerTest();

  return pass;
}

static void stabilizerTask(void* param)
{
  uint32_t attitudeCounter = 0;
  portTickType lastWakeTime;

  vTaskSetApplicationTaskTag(0, (pdTASK_HOOK_CODE)TASK_STABILIZER_ID_NBR);

  //Wait for the system to be fully started to start stabilization loop
  systemWaitStart();

  lastWakeTime = xTaskGetTickCount ();

  while(1)
  {
    vTaskDelayUntil(&lastWakeTime, F2T(IMU_UPDATE_FREQ));

    imu6Read(&gyro, &acc);

    if (imu6IsCalibrated())
    {
      commanderGetRPY(&eulerRollDesired, &eulerPitchDesired, &eulerYawDesired);
      commanderGetRPYType(&rollType, &pitchType, &yawType);

      if (++attitudeCounter >= ATTITUDE_UPDATE_RATE_DIVIDER)
      {
        sensfusion6UpdateQ(gyro.x, gyro.y, gyro.z, acc.x, acc.y, acc.z, FUSION_UPDATE_DT);
        sensfusion6GetEulerRPY(&eulerRollActual, &eulerPitchActual, &eulerYawActual);

        controllerCorrectAttitudePID(eulerRollActual, eulerPitchActual, eulerYawActual,
                                     eulerRollDesired, eulerPitchDesired, -eulerYawDesired,
                                     &rollRateDesired, &pitchRateDesired, &yawRateDesired);
        attitudeCounter = 0;
      }

      if (rollType == RATE)
      {
        rollRateDesired = eulerRollDesired;
      }
      if (pitchType == RATE)
      {
        pitchRateDesired = eulerPitchDesired;
      }
      if (yawType == RATE)
      {
        yawRateDesired = -eulerYawDesired;
      }

      // TODO: Investigate possibility to subtract gyro drift.
      controllerCorrectRatePID(gyro.x, -gyro.y, gyro.z,
                               rollRateDesired, pitchRateDesired, yawRateDesired);

      controllerGetActuatorOutput(&actuatorRoll, &actuatorPitch, &actuatorYaw);

      commanderGetTrust(&actuatorThrust);
      if (actuatorThrust > 0)
      {
#if defined(TUNE_ROLL)
        distributePower(actuatorThrust, actuatorRoll, 0, 0);
#elif defined(TUNE_PITCH)
        distributePower(actuatorThrust, 0, actuatorPitch, 0);
#elif defined(TUNE_YAW)
        distributePower(actuatorThrust, 0, 0, -actuatorYaw);
#else
        distributePower(actuatorThrust, actuatorRoll, actuatorPitch, -actuatorYaw);
#endif
      }
      else
      {
        distributePower(0, 0, 0, 0);
        controllerResetAllPID();
      }
#if 0
     static int i = 0;
      if (++i > 19)
      {
        uartPrintf("%i, %i, %i\n",
            (int32_t)(eulerRollActual*100),
            (int32_t)(eulerPitchActual*100),
            (int32_t)(eulerYawActual*100));
        i = 0;
      }
#endif
    }
  }
}

static void distributePower(const uint16_t thrust, const int16_t roll,
                            const int16_t pitch, const int16_t yaw)
{
#ifdef QUAD_FORMATION_X
  roll = roll >> 1;
  pitch = pitch >> 1;
  motorPowerM1 = limitThrust(thrust - roll + pitch + yaw);
  motorPowerM2 = limitThrust(thrust - roll - pitch - yaw);
  motorPowerM3 =  limitThrust(thrust + roll - pitch + yaw);
  motorPowerM4 =  limitThrust(thrust + roll + pitch - yaw);
#else // QUAD_FORMATION_NORMAL
  motorPowerM1 = limitThrust(thrust + pitch + yaw);
  motorPowerM2 = limitThrust(thrust - roll - yaw);
  motorPowerM3 =  limitThrust(thrust - pitch + yaw);
  motorPowerM4 =  limitThrust(thrust + roll - yaw);
#endif

  motorsSetRatio(MOTOR_M1, motorPowerM1);
  motorsSetRatio(MOTOR_M2, motorPowerM2);
  motorsSetRatio(MOTOR_M3, motorPowerM3);
  motorsSetRatio(MOTOR_M4, motorPowerM4);
}

static uint16_t limitThrust(int32_t value)
{
  if(value > UINT16_MAX)
  {
    value = UINT16_MAX;
  }
  else if(value < 0)
  {
    value = 0;
  }

  return (uint16_t)value;
}
