PJayChen/Crazyflies/4x_app_crazyflie_rel_a/hal/src/pm.c

/**
 *    ||          ____  _ __                           
 * +------+      / __ )(_) /_______________ _____  ___ 
 * | 0xBC |     / __  / / __/ ___/ ___/ __ `/_  / / _ \
 * +------+    / /_/ / / /_/ /__/ /  / /_/ / / /_/  __/
 *  ||  ||    /_____/_/\__/\___/_/   \__,_/ /___/\___/
 *
 * Crazyflie control firmware
 *
 * Copyright (C) 2011-2012 Bitcraze AB
 *
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
 * pm.c - Power Management driver and functions.
 */

#include "stm32f10x_conf.h"
#include <string.h>
#include <stdbool.h>

#include "FreeRTOS.h"
#include "task.h"
#include "semphr.h"

#include "system.h"
#include "pm.h"
#include "led.h"
#include "log.h"
#include "adc.h"
#include "ledseq.h"
#include "commander.h"
//#include "radiolink.h"

static float    batteryVoltage;
static float    batteryVoltageMin = 6.0;
static float    batteryVoltageMax = 0.0;
static int32_t  batteryVRawFilt = PM_BAT_ADC_FOR_3_VOLT;
static int32_t  batteryVRefRawFilt = PM_BAT_ADC_FOR_1p2_VOLT;
static uint32_t batteryLowTimeStamp;
static uint32_t batteryCriticalLowTimeStamp;
static bool isInit;

const static float bat671723HS25C[10] =
{
  3.00, // 00%
  3.78, // 10%
  3.83, // 20%
  3.87, // 30%
  3.89, // 40%
  3.92, // 50%
  3.96, // 60%
  4.00, // 70%
  4.04, // 80%
  4.10  // 90%
};

/******************************
LOG_GROUP_START(pm)
LOG_ADD(LOG_FLOAT, vbat, &batteryVoltage)
LOG_GROUP_STOP(pm)
********************************/

void logpminit(logsvar *plogsint)
{
	plogsint->logs_pm[0].type=LOG_GROUP | LOG_START;
	plogsint->logs_pm[0].name="pm";
	plogsint->logs_pm[0].address=0x0;
	plogsint->logs_pm[1].type=LOG_FLOAT;
	plogsint->logs_pm[1].name="vbat";
	plogsint->logs_pm[1].address=&batteryVoltage;
	plogsint->logs_pm[2].type=LOG_GROUP | LOG_STOP;
	plogsint->logs_pm[2].name="stop_pm";
	plogsint->logs_pm[2].address=0x0;
}

void pmInit(void)
{
  GPIO_InitTypeDef GPIO_InitStructure;

  if(isInit)
    return;

  RCC_APB2PeriphClockCmd(PM_GPIO_IN_PGOOD_PERIF | PM_GPIO_IN_CHG_PERIF |
                         PM_GPIO_SYSOFF_PERIF | PM_GPIO_EN1_PERIF | 
                         PM_GPIO_EN2_PERIF | PM_GPIO_BAT_PERIF, ENABLE);

  // Configure PM PGOOD pin (Power good)
  GPIO_InitStructure.GPIO_Mode = GPIO_Mode_IN_FLOATING;
  GPIO_InitStructure.GPIO_Speed = GPIO_Speed_2MHz;
  GPIO_InitStructure.GPIO_Pin = PM_GPIO_IN_PGOOD;
  GPIO_Init(PM_GPIO_IN_PGOOD_PORT, &GPIO_InitStructure);
  // Configure PM CHG pin (Charge)
  GPIO_InitStructure.GPIO_Mode = GPIO_Mode_IPU;
  GPIO_InitStructure.GPIO_Speed = GPIO_Speed_2MHz;
  GPIO_InitStructure.GPIO_Pin = PM_GPIO_IN_CHG;
  GPIO_Init(PM_GPIO_IN_CHG_PORT, &GPIO_InitStructure);
  // Configure PM EN2 pin
  GPIO_InitStructure.GPIO_Pin = PM_GPIO_EN2;
  GPIO_InitStructure.GPIO_Mode = GPIO_Mode_Out_PP;
  GPIO_InitStructure.GPIO_Speed = GPIO_Speed_10MHz;
  GPIO_Init(PM_GPIO_EN2_PORT, &GPIO_InitStructure);
  // Configure PM EN1 pin
  GPIO_InitStructure.GPIO_Pin = PM_GPIO_EN1;
  GPIO_InitStructure.GPIO_Mode = GPIO_Mode_Out_PP;
  GPIO_InitStructure.GPIO_Speed = GPIO_Speed_10MHz;
  GPIO_Init(PM_GPIO_EN1_PORT, &GPIO_InitStructure);
  // Configure PM SYSOFF pin
  GPIO_InitStructure.GPIO_Pin = PM_GPIO_SYSOFF;
  GPIO_InitStructure.GPIO_Mode = GPIO_Mode_Out_PP;
  GPIO_InitStructure.GPIO_Speed = GPIO_Speed_10MHz;
  GPIO_Init(PM_GPIO_SYSOFF_PORT, &GPIO_InitStructure);
  // Configure battery ADC pin
  GPIO_InitStructure.GPIO_Mode = GPIO_Mode_IN_FLOATING;
  GPIO_InitStructure.GPIO_Speed = GPIO_Speed_10MHz;
  GPIO_InitStructure.GPIO_Pin = PM_GPIO_BAT;
  GPIO_Init(PM_GPIO_BAT_PORT, &GPIO_InitStructure);
  
  
  xTaskCreate(pmTask, (const signed char *)"PWRMGNT",
              configMINIMAL_STACK_SIZE, NULL, /*priority*/3, NULL);
  
  isInit = true;
}

bool pmTest(void)
{
  return isInit;
}

/**
 * IIR low pass filter the samples.
 */
static int16_t pmBatteryIIRLPFilter(uint16_t in, int32_t* filt)
{
  int32_t inScaled;
  int32_t filttmp = *filt;
  int16_t out;

  // Shift to keep accuracy
  inScaled = in << PM_BAT_IIR_SHIFT;
  // Calculate IIR filter
  filttmp = filttmp + (((inScaled-filttmp) >> 8) * PM_BAT_IIR_LPF_ATT_FACTOR);
  // Scale and round
  out = (filttmp >> 8) + ((filttmp & (1 << (PM_BAT_IIR_SHIFT - 1))) >> (PM_BAT_IIR_SHIFT - 1));
  *filt = filttmp;

  return out;
}

/**
 * Sets the battery voltage and its min and max values
 */
static void pmSetBatteryVoltage(float voltage)
{
  batteryVoltage = voltage;
  if (batteryVoltageMax < voltage)
  {
    batteryVoltageMax = voltage;
  }
  if (batteryVoltageMin > voltage)
  {
    batteryVoltageMin = voltage;
  }
}

/**
 * Shutdown system
 */
static void pmSystemShutdown(void)
{
#ifdef ACTIVATE_AUTO_SHUTDOWN
  GPIO_SetBits(PM_GPIO_SYSOFF_PORT, PM_GPIO_SYSOFF);
#endif
}

/**
 * Returns a number from 0 to 9 where 0 is completely discharged
 * and 9 is 90% charged.
 */
static int32_t pmBatteryChargeFromVoltage(float voltage)
{
  int charge = 0;

  if (voltage < bat671723HS25C[0])
  {
    return 0;
  }
  if (voltage > bat671723HS25C[9])
  {
    return 9;
  }
  while (voltage >  bat671723HS25C[charge])
  {
    charge++;
  }

  return charge;
}


float pmGetBatteryVoltage(void)
{
  return batteryVoltage;
}

float pmGetBatteryVoltageMin(void)
{
  return batteryVoltageMin;
}

float pmGetBatteryVoltageMax(void)
{
  return batteryVoltageMax;
}

void pmBatteryUpdate(AdcGroup* adcValues)
{
  float vBat;
  int16_t vBatRaw;
  int16_t vBatRefRaw;

  vBatRaw = pmBatteryIIRLPFilter(adcValues->vbat.val, &batteryVRawFilt);
  vBatRefRaw = pmBatteryIIRLPFilter(adcValues->vbat.vref, &batteryVRefRawFilt);

  vBat = adcConvertToVoltageFloat(vBatRaw, vBatRefRaw) * PM_BAT_DIVIDER;
  pmSetBatteryVoltage(vBat);
}

void pmSetChargeState(PMChargeStates chgState)
{
  switch (chgState)
  {
    case charge100mA:
      GPIO_ResetBits(PM_GPIO_EN1_PORT, PM_GPIO_EN1);
      GPIO_ResetBits(PM_GPIO_EN2_PORT, PM_GPIO_EN2);
      break;
    case charge500mA:
      GPIO_SetBits(PM_GPIO_EN1_PORT, PM_GPIO_EN1);
      GPIO_ResetBits(PM_GPIO_EN2_PORT, PM_GPIO_EN2);
      break;
    case chargeMax:
      GPIO_ResetBits(PM_GPIO_EN1_PORT, PM_GPIO_EN1);
      GPIO_SetBits(PM_GPIO_EN2_PORT, PM_GPIO_EN2);
      break;
  }
}

PMStates pmUpdateState()
{
  PMStates pmState;
  bool isCharging = !GPIO_ReadInputDataBit(PM_GPIO_IN_CHG_PORT, PM_GPIO_IN_CHG);
  bool isPgood = !GPIO_ReadInputDataBit(PM_GPIO_IN_PGOOD_PORT, PM_GPIO_IN_PGOOD);
  uint32_t batteryLowTime;

  batteryLowTime = xTaskGetTickCount() - batteryLowTimeStamp;

  if (isPgood && !isCharging)
  {
    pmState = charged;
  }
  else if (isPgood && isCharging)
  {
    pmState = charging;
  }
  else if (!isPgood && !isCharging && (batteryLowTime > PM_BAT_LOW_TIMEOUT))
  {
    pmState = lowPower;
  }
  else
  {
    pmState = battery;
  }

  return pmState;
}

void pmTask(void *param)
{
  PMStates pmState;
  PMStates pmStateOld = battery;
  uint32_t tickCount;

  vTaskSetApplicationTaskTag(0, (pdTASK_HOOK_CODE)TASK_PM_ID_NBR);

  tickCount = xTaskGetTickCount();
  batteryLowTimeStamp = tickCount;
  batteryCriticalLowTimeStamp = tickCount;

  pmSetChargeState(charge500mA);

  vTaskDelay(1000);

  while(1)
  {
    vTaskDelay(100);
    tickCount = xTaskGetTickCount();

    if (pmGetBatteryVoltage() > PM_BAT_LOW_VOLTAGE)
    {
      batteryLowTimeStamp = tickCount;
    }
    if (pmGetBatteryVoltage() > PM_BAT_CRITICAL_LOW_VOLTAGE)
    {
      batteryCriticalLowTimeStamp = tickCount;
    }

    pmState = pmUpdateState();

    if (pmState != pmStateOld)
    {
      // Actions on state change
      switch (pmState)
      {
        case charged:
          ledseqStop(LED_GREEN, seq_charging);
          ledseqRun(LED_GREEN, seq_charged);
          systemSetCanFly(false);
          break;
        case charging:
          ledseqStop(LED_RED, seq_lowbat);
          ledseqStop(LED_GREEN, seq_charged);
          ledseqRun(LED_GREEN, seq_charging);
          systemSetCanFly(false);
          //Due to voltage change radio must be restarted
//          radiolinkReInit();
          break;
        case lowPower:
          ledseqRun(LED_RED, seq_lowbat);
          systemSetCanFly(true);
          break;
        case battery:
          ledseqStop(LED_GREEN, seq_charging);
          ledseqStop(LED_GREEN, seq_charged);
          systemSetCanFly(true);
          //Due to voltage change radio must be restarted
//          radiolinkReInit();
          break;
        default:
          systemSetCanFly(true);
          break;
      }
      pmStateOld = pmState;
    }
    // Actions during state
    switch (pmState)
    {
      case charged:
        break;
      case charging:
        {
          uint32_t onTime;

          onTime = pmBatteryChargeFromVoltage(pmGetBatteryVoltage()) *
                   (LEDSEQ_CHARGE_CYCLE_TIME / 10);
          ledseqSetTimes(seq_charging, onTime, LEDSEQ_CHARGE_CYCLE_TIME - onTime);
        }
        break;
      case lowPower:
        {
          uint32_t batteryCriticalLowTime;

          batteryCriticalLowTime = tickCount - batteryCriticalLowTimeStamp;
          if (batteryCriticalLowTime > PM_BAT_CRITICAL_LOW_TIMEOUT)
          {
            pmSystemShutdown();
          }
        }
        break;
      case battery:
        {
          if ((commanderGetInactivityTime() > PM_SYSTEM_SHUTDOWN_TIMEOUT))
          {
            pmSystemShutdown();
          }
        }
        break;
      default:
        break;
    }
  }
}
