PJayChen/Crazyflies/4x_app_crazyflie_rel_a/modules/src/log.c

/**
 *    ||          ____  _ __                           
 * +------+      / __ )(_) /_______________ _____  ___ 
 * | 0xBC |     / __  / / __/ ___/ ___/ __ `/_  / / _ \
 * +------+    / /_/ / / /_/ /__/ /  / /_/ / / /_/  __/
 *  ||  ||    /_____/_/\__/\___/_/   \__,_/ /___/\___/
 *
 * Crazyflie control firmware
 *
 * Copyright (C) 2012 BitCraze AB
 *
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
 * log.c: Dynamic log system
 */

/* The TOC logic is mainly based on param.c
 * FIXME: See if we can factorise the TOC code */

#include <string.h>
#include <errno.h>
#include <stdint.h>
#include <stdbool.h>

/* FreeRtos includes */
#include "FreeRTOS.h"
#include "task.h"
#include "timers.h"
#include "semphr.h"

#include "config.h"
#include "crtp.h"
#include "log.h"
#include "crc.h"
#include "worker.h"
#include "fp16.h"

#include "console.h"

#include "pm.h"
#include "stabilizer.h"

logsvar logsint;

#define ENOEXEC 8 /* Exec format error */
#define ENOENT 2 /* No such file or directory */
#define E2BIG 7 /* Arg list too long */

#if 0
#define DEBUG(fmt, ...) consolePrintf("D/log " fmt, ## __VA_ARGS__)
#define ERROR(fmt, ...) consolePrintf("E/log " fmt, ## __VA_ARGS__)
#else
#define DEBUG(...)
#define ERROR(...)
#endif


static const uint8_t typeLength[] = {
  [LOG_UINT8]  = 1,
  [LOG_UINT16] = 2,
  [LOG_UINT32] = 4,
  [LOG_INT8]   = 1,
  [LOG_INT16]  = 2,
  [LOG_INT32]  = 4,
  [LOG_FLOAT]  = 4,
  [LOG_FP16]   = 2,
};

// Maximum log payload length
#define LOG_MAX_LEN 30

/* Log packet parameters storage */
#define LOG_MAX_OPS 64
#define LOG_MAX_BLOCKS 8
struct log_ops {
  struct log_ops * next;
  uint8_t storageType : 4;
  uint8_t logType     : 4;
  void * variable;
};

struct log_block {
  int id;
  xTimerHandle timer;
  struct log_ops * ops;
};

static struct log_ops logOps[LOG_MAX_OPS];
static struct log_block logBlocks[LOG_MAX_BLOCKS];
static xSemaphoreHandle logLock;

struct ops_setting {
    uint8_t logType;
    uint8_t id;
} __attribute__((packed));


#define TOC_CH      0
#define CONTROL_CH  1
#define LOG_CH      2

#define CMD_GET_ITEM 0
#define CMD_GET_INFO 1

#define CONTROL_CREATE_BLOCK 0
#define CONTROL_APPEND_BLOCK 1
#define CONTROL_DELETE_BLOCK 2
#define CONTROL_START_BLOCK  3
#define CONTROL_STOP_BLOCK   4
#define CONTROL_RESET        5

#define BLOCK_ID_FREE -1

//Private functions
static void logTask(void * prm);
static void logTOCProcess(int command);
static void logControlProcess(void);

void logRunBlock(void * arg);
void logBlockTimed(xTimerHandle timer);

//These are set by the Linker
//extern struct log_s _log_start;
//extern struct log_s _log_stop;

//Pointer to the logeters list and length of it
struct log_s * logs;
static int logsLen;
static uint32_t logsCrc;
static int logsCount = 0;

static bool isInit = false;

/* Log management functions */
static int logAppendBlock(int id, struct ops_setting * settings, int len);
static int logCreateBlock(unsigned char id, struct ops_setting * settings, int len);
static int logDeleteBlock(int id);
static int logStartBlock(int id, unsigned int period);
static int logStopBlock(int id);
static void logReset(void);

void logInit(void)
{
  int i;
  
  if(isInit)
    return;
	
	logpminit(&logsint);
	logstabinit(&logsint);

  logs = (struct log_s *)&logsint;
  logsLen = (int)&logsint.logs_acc[4].address - (int)&logsint.logs_pm[0].type;
  logsCrc = crcSlow(logs, logsLen);
  
  // Big lock that protects the log datastructures
  logLock = xSemaphoreCreateMutex();

  for (i=0; i<logsLen; i++)
  {
    if(!(logs[i].type & LOG_GROUP)) 
      logsCount++;
  }
 
  //Manually free all log blocks
  for(i=0; i<LOG_MAX_BLOCKS; i++)
    logBlocks[i].id = BLOCK_ID_FREE;

  //Init data structures and set the log subsystem in a known state
  logReset();
  
  //Start the log task
  xTaskCreate(logTask, (const signed char *)"log",
    configMINIMAL_STACK_SIZE, NULL, /*priority*/1, NULL);

  isInit = true;
}

bool logTest(void)
{
  return isInit;
}

static CRTPPacket p;

void logTask(void * prm)
{
	crtpInitTaskQueue(CRTP_PORT_LOG);
	
	while(1) {
		crtpReceivePacketBlock(CRTP_PORT_LOG, &p);
		
		xSemaphoreTake(logLock, portMAX_DELAY);
		if (p.channel==TOC_CH)
		  logTOCProcess(p.data[0]);
		if (p.channel==CONTROL_CH)
		  logControlProcess();
		xSemaphoreGive(logLock);
	}
}

void logTOCProcess(int command)
{
  int ptr = 0;
  char * group = "plop";
  int n=0;
  
  switch (command)
  {
  case CMD_GET_INFO: //Get info packet about the log implementation
    DEBUG("Packet is TOC_GET_INFO\n");
    ptr = 0;
    group = "";
    p.header=CRTP_HEADER(CRTP_PORT_LOG, TOC_CH);
    p.size=8;
    p.data[0]=CMD_GET_INFO;
    p.data[1]=logsCount;
    memcpy(&p.data[2], &logsCrc, 4);
    p.data[6]=LOG_MAX_BLOCKS;
    p.data[7]=LOG_MAX_OPS;
    crtpSendPacket(&p);
    break;
  case CMD_GET_ITEM:  //Get log variable
    DEBUG("Packet is TOC_GET_ITEM Id: %d\n", p.data[1]);
    for (ptr=0; ptr<logsLen; ptr++) //Ptr points a group
    {
      if (logs[ptr].type & LOG_GROUP)
      {
        if (logs[ptr].type & LOG_START)
          group = logs[ptr].name;
        else
          group = "";
      }
      else                          //Ptr points a variable
      {
        if (n==p.data[1])
          break;
        n++;
      }
    }
    
    if (ptr<logsLen)
    {
      DEBUG("    Item is \"%s\":\"%s\"\n", group, logs[ptr].name);
      p.header=CRTP_HEADER(CRTP_PORT_LOG, TOC_CH);
      p.data[0]=CMD_GET_ITEM;
      p.data[1]=n;
      p.data[2]=logs[ptr].type;
      memcpy(p.data+3, group, strlen(group)+1);
      memcpy(p.data+3+strlen(group)+1, logs[ptr].name, strlen(logs[ptr].name)+1);
      p.size=3+2+strlen(group)+strlen(logs[ptr].name);
      crtpSendPacket(&p);      
    } else {
      DEBUG("    Index out of range!");
      p.header=CRTP_HEADER(CRTP_PORT_LOG, TOC_CH);
      p.data[0]=CMD_GET_ITEM;
      p.size=1;
      crtpSendPacket(&p);
    }
    break;
  }
}

void logControlProcess()
{
  int ret = ENOEXEC;

  switch(p.data[0])
  {
    case CONTROL_CREATE_BLOCK:
      ret = logCreateBlock( p.data[1],
                            (struct ops_setting*)&p.data[2], 
                            (p.size-2)/sizeof(struct ops_setting) );
      break;
    case CONTROL_APPEND_BLOCK:
      ret = logAppendBlock( p.data[1],
                            (struct ops_setting*)&p.data[2], 
                            (p.size-2)/sizeof(struct ops_setting) );
      break;
    case CONTROL_DELETE_BLOCK:
      ret = logDeleteBlock( p.data[1] );
      break;
    case CONTROL_START_BLOCK:
      ret = logStartBlock( p.data[1], p.data[2]*10);
      break;
    case CONTROL_STOP_BLOCK:
      ret = logStopBlock( p.data[1] );
      break;
    case CONTROL_RESET:
      logReset();
      ret = 0;
      break;
  }
  
  //Commands answer
  p.data[2] = ret;
  p.size = 3;
  crtpSendPacket(&p);
}

static int logCreateBlock(unsigned char id, struct ops_setting * settings, int len)
{
  int i;
  
  for (i=0; i<LOG_MAX_BLOCKS; i++)
    if (logBlocks[i].id == BLOCK_ID_FREE) break;
  
  if (i == LOG_MAX_BLOCKS)
    return ENOMEM;
  
  logBlocks[i].id = id;
  logBlocks[i].timer = xTimerCreate( (const signed char *)"logTimer", M2T(1000), 
                                     pdTRUE, &logBlocks[i], logBlockTimed );
  logBlocks[i].ops = NULL;
  
  if (logBlocks[i].timer == NULL)
  {
	logBlocks[i].id = BLOCK_ID_FREE;
	return ENOMEM;
  }

  DEBUG("Added block ID %d\n", id);
  
  return logAppendBlock(id, settings, len);
}

static int blockCalcLength(struct log_block * block);
static struct log_ops * opsMalloc(void);
static void opsFree(struct log_ops * ops);
static void blockAppendOps(struct log_block * block, struct log_ops * ops);
static int variableGetIndex(int id);

static int logAppendBlock(int id, struct ops_setting * settings, int len)
{
  int i;
  struct log_block * block;
  
  DEBUG("Appending %d variable to block %d\n", len, id);
  
  for (i=0; i<LOG_MAX_BLOCKS; i++)
    if (logBlocks[i].id == id) break;
  
  if (i >= LOG_MAX_BLOCKS) {
    ERROR("Trying to append block id %d that doesn't exist.", id);
    return ENOENT;
  }
  
  block = &logBlocks[i];
  
  for (i=0; i<len; i++)
  {
    int currentLength = blockCalcLength(block);
    struct log_ops * ops;
    int varId;
    
    if ((currentLength + typeLength[settings[i].logType&0x0F])>LOG_MAX_LEN) {
      ERROR("Trying to append a full block. Block id %d.\n", id);
      return E2BIG;
    }
    
    ops = opsMalloc();
    
    if(!ops) {
      ERROR("No more ops memory free!\n");
      return ENOMEM;
    }
    
    if (settings[i].id != 255)  //TOC variable
    {
      varId = variableGetIndex(settings[i].id);
      
      if (varId<0) {
        ERROR("Trying to add variable Id %d that does not exists.", settings[i].id);
        return ENOENT;
      }
      
      ops->variable    = logs[varId].address;
      ops->storageType = logs[varId].type;
      ops->logType     = settings[i].logType&0x0F;
      
      DEBUG("Appended variable %d to block %d\n", settings[i].id, id);
    } else {                     //Memory variable
      //TODO: Check that the address is in ram
      ops->variable    = (void*)(&settings[i]+1);
      ops->storageType = (settings[i].logType>>4)&0x0F;
      ops->logType     = settings[i].logType&0x0F;
      i += 2;
      
      DEBUG("Appended var addr 0x%x to block %d\n", (int)ops->variable, id);
    }
    blockAppendOps(block, ops);
    
    DEBUG("   Now lenght %d\n", blockCalcLength(block));
  }
  
  return 0;
}

static int logDeleteBlock(int id)
{
  int i;
  struct log_ops * ops;
  struct log_ops * opsNext;
  
  for (i=0; i<LOG_MAX_BLOCKS; i++)
    if (logBlocks[i].id == id) break;
  
  if (i >= LOG_MAX_BLOCKS) {
    ERROR("trying to delete block id %d that doesn't exist.", id);
    return ENOENT;
  }
  
  ops = logBlocks[i].ops;
  while (ops)
  {
    opsNext = ops->next;
    opsFree(ops);
    ops = opsNext;
  }
  
  if (logBlocks[i].timer != 0) {
    xTimerStop(logBlocks[i].timer, portMAX_DELAY);
    xTimerDelete(logBlocks[i].timer, portMAX_DELAY);
    logBlocks[i].timer = 0;
  }
  
  logBlocks[i].id = BLOCK_ID_FREE;
  return 0;
}

static int logStartBlock(int id, unsigned int period)
{
  int i;
  
  for (i=0; i<LOG_MAX_BLOCKS; i++)
    if (logBlocks[i].id == id) break;
  
  if (i >= LOG_MAX_BLOCKS) {
    ERROR("Trying to start block id %d that doesn't exist.", id);
    return ENOENT;
  }
  
  DEBUG("Starting block %d with period %dms\n", id, period);
  
  if (period>0)
  {
    xTimerChangePeriod(logBlocks[i].timer, M2T(period), 100);
    xTimerStart(logBlocks[i].timer, 100);
  } else {
    // single-shoot run
    workerSchedule(logRunBlock, &logBlocks[i]);
  }
  
  return 0;
}

static int logStopBlock(int id)
{
  int i;
  
  for (i=0; i<LOG_MAX_BLOCKS; i++)
    if (logBlocks[i].id == id) break;
  
  if (i >= LOG_MAX_BLOCKS) {
    ERROR("Trying to stop block id %d that doesn't exist.\n", id);
    return ENOENT;
  }
  
  xTimerStop(logBlocks[i].timer, portMAX_DELAY);
  
  return 0;
}

/* This function is called by the timer subsystem */
void logBlockTimed(xTimerHandle timer)
{
  workerSchedule(logRunBlock, pvTimerGetTimerID(timer));
}

/* This function is usually called by the worker subsystem */
void logRunBlock(void * arg)
{
  struct log_block *blk = arg;
  struct log_ops *ops = blk->ops;
  static CRTPPacket pk;
  unsigned int timestamp;
  
  xSemaphoreTake(logLock, portMAX_DELAY);

  timestamp = ((long long)xTaskGetTickCount()*1000)/portTICK_RATE_MS;
  
  pk.header = CRTP_HEADER(CRTP_PORT_LOG, LOG_CH);
  pk.size = 4;
  pk.data[0] = blk->id;
  pk.data[1] = timestamp&0x0ff;
  pk.data[2] = (timestamp>>8)&0x0ff;
  pk.data[2] = (timestamp>>16)&0x0ff;

  while (ops)
  {
    int valuei = 0;
    float valuef = 0;
     
    switch(ops->storageType)
    {
      case LOG_UINT8:
        valuei = *(uint8_t *)ops->variable;
        break;
      case LOG_INT8:
        valuei = *(int8_t *)ops->variable;
        break;
      case LOG_UINT16:
        valuei = *(uint16_t *)ops->variable;
        break;
      case LOG_INT16:
        valuei = *(int16_t *)ops->variable;
        break;
      case LOG_UINT32:
        valuei = *(uint32_t *)ops->variable;
        break;
      case LOG_INT32:
        valuei = *(int32_t *)ops->variable;
        break;
      case LOG_FLOAT:
        valuei = *(float *)ops->variable;
        break;
    }
    
    if (ops->logType == LOG_FLOAT || ops->logType == LOG_FP16)
    {
      if (ops->storageType == LOG_FLOAT)
        valuef = *(float *)ops->variable;
      else
        valuef = valuei;
      
      if (ops->logType == LOG_FLOAT)
      {
        memcpy(&pk.data[pk.size], &valuef, 4);
        pk.size += 4;
      }
      else
      {
        valuei = single2half(valuef);
        memcpy(&pk.data[pk.size], &valuei, 2);
        pk.size += 2;
      }
    }
    else  //logType is an integer
    {
      memcpy(&pk.data[pk.size], &valuei, typeLength[ops->logType]);
      pk.size += typeLength[ops->logType];
    }
    
    ops = ops->next;
  }
  
  xSemaphoreGive(logLock);

  crtpSendPacket(&pk);
}

static int variableGetIndex(int id)
{
  int i;
  int n=0;
  
  for (i=0; i<logsLen; i++)
  {
    if(!(logs[i].type & LOG_GROUP)) 
    {
      if(n==id)
        break;
      n++;
    }
  }
  
  if (i>=logsLen)
    return -1;
  
  return i;
}

static struct log_ops * opsMalloc()
{
  int i;

  for (i=0;i<LOG_MAX_OPS; i++)
      if (logOps[i].variable == NULL) break;

  if (i >= LOG_MAX_OPS)
      return NULL;

  return &logOps[i];
}

static void opsFree(struct log_ops * ops)
{
  ops->variable = NULL;
}

static int blockCalcLength(struct log_block * block)
{
  struct log_ops * ops;
  int len = 0;
  
  for (ops = block->ops; ops; ops = ops->next)
    len += typeLength[ops->logType];

  return len;
}

void blockAppendOps(struct log_block * block, struct log_ops * ops)
{
  struct log_ops * o;
  
  ops->next = NULL;
  
  if (block->ops == NULL)
    block->ops = ops;
  else
  {
    for (o = block->ops; o->next; o = o->next);
    
    o->next = ops;
  }
}

static void logReset(void)
{
  int i;
  
  if (isInit)
  {
    //Stop and delete all started log blocks
    for(i=0; i<LOG_MAX_BLOCKS; i++)
      if (logBlocks[i].id != -1)
      {
        logStopBlock(logBlocks[i].id);
        logDeleteBlock(logBlocks[i].id);
      }
  }
  
  //Force free all the log block objects
  for(i=0; i<LOG_MAX_BLOCKS; i++)
    logBlocks[i].id = BLOCK_ID_FREE;
  
  //Force free the log ops
  for (i=0; i<LOG_MAX_OPS; i++)
    logOps[i].variable = NULL;
}
