PJayChen/Crazyflies/4x_app_crazyflie_rel_a/hal/src/eskylink.c

/*
 *    ||          ____  _ __                           
 * +------+      / __ )(_) /_______________ _____  ___ 
 * | 0xBC |     / __  / / __/ ___/ ___/ __ `/_  / / _ \
 * +------+    / /_/ / / /_/ /__/ /  / /_/ / / /_/  __/
 *  ||  ||    /_____/_/\__/\___/_/   \__,_/ /___/\___/
 *
 * Crazyflie control firmware
 *
 * Copyright (C) 2012 BitCraze AB
 *
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
 * eskylink.c: esky 2.4GHz-compatible link driver
 */
/*
 * Experimental code!
 * This link implements the ESky remote protocol using the nRF24L01p chip and
 * sends CRTP packets to the commander.
 *
 * Thanks to 'dvdouden' for documenting the protocol!
 *  -> http://www.deviationtx.com/forum/protocol-development/1059-esky-protocol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
 *  -> http://sourceforge.net/p/arduinorclib/wiki/Esky%20Radio/
 */

#include <stdbool.h>
#include <errno.h>
#include <string.h>

#include "nrf24l01.h"
#include "crtp.h"
#include "configblock.h"
#include "ledseq.h"

#include "FreeRTOS.h"
#include "task.h"
#include "queue.h"
#include "semphr.h"

#define ENETDOWN 100 /* Network is down */

/* FIXME: This might be a bit tight range? */
#define PPM_ZERO 1500
#define PPM_RANGE 500
#define PPM_MIN 1000
#define PPM_MAX 2000

static bool isInit;

static char address[4] = {0x00, 0x00, 0x00, 0xBB};
static char packet[32];

/* Synchronisation */
xSemaphoreHandle dataRdy;
/* Data queue */
xQueueHandle rxQueue;

static struct {
  bool enabled;
  
  bool paired;
  uint8_t band;
} state;

static void interruptCallback()
{
  portBASE_TYPE  xHigherPriorityTaskWoken = pdFALSE;

  //To unlock RadioTask
  xSemaphoreGiveFromISR(dataRdy, &xHigherPriorityTaskWoken);

  if(xHigherPriorityTaskWoken)
  	portYIELD();
//    vPortYieldFromISR();
}

// 'Class' functions, called from callbacks
static int setEnable(bool enable)
{
  nrfSetEnable(enable);
  state.enabled = enable;

  return 0;
}

static int sendPacket(CRTPPacket * pk)
{
  if (!state.enabled)
    return ENETDOWN;
  
  // NOP!
  
  return 0;
}

static int receivePacket(CRTPPacket * pk)
{
  if (!state.enabled)
    return ENETDOWN;

  xQueueReceive( rxQueue, pk, portMAX_DELAY);

  return 0;
}

static struct crtpLinkOperations eskyOp =
{
  .setEnable         = setEnable,
  .sendPacket        = sendPacket,
  .receivePacket     = receivePacket,
};

static int eskylinkFetchData(char * packet, int dataLen)
{
  nrfSetEnable(false);

  //Fetch the data
  nrfReadRX(packet, dataLen);

  //clear the interruptions flags
  nrfWrite1Reg(REG_STATUS, 0x70);
  
  nrfSetEnable(true);
  
  return dataLen;
}

static void eskylinkInitPairing(void)
{
  int i;
  
  //Power the radio, Enable the DR interruption, set the radio in PRX mode with 2bytes CRC
  nrfWrite1Reg(REG_CONFIG, 0x3F);
  vTaskDelay(M2T(2)); //Wait for the chip to be ready
  
   //Set the radio channel, pairing channel is 50
  nrfSetChannel(50);
  //Set the radio data rate
  nrfSetDatarate(RADIO_RATE_1M);

  nrfWrite1Reg(REG_SETUP_AW, VAL_SETUP_AW_3B); // 3 bytes address
  address[0] = address[1] = address[2] = 0;
  nrfWriteReg(REG_RX_ADDR_P0, address, 3);     // Pipe address == 0
  nrfWrite1Reg(REG_EN_RXADDR, 0x01);
  nrfWrite1Reg(REG_FEATURE, 0x00);             // No dynamic size payload
  nrfWrite1Reg(REG_DYNPD, 0x00);
  nrfWrite1Reg(REG_RX_PW_P0, 13);              //13 bytes payload
  nrfWrite1Reg(REG_EN_AA, 0);                  //Disable shockburst

  //Flush RX
  for(i=0;i<3;i++)
    nrfFlushRx();
  //Flush TX
  for(i=0;i<3;i++)
    nrfFlushTx();
}

static void eskylinkInitPaired(int channel)
{
  nrfSetChannel(channel);
  nrfSetDatarate(RADIO_RATE_1M);

  nrfWrite1Reg(REG_SETUP_AW, VAL_SETUP_AW_4B); // 4 bytes address
  nrfWriteReg(REG_RX_ADDR_P0, address, 4);     // Pipe address == from pairing packet
  nrfWrite1Reg(REG_EN_RXADDR, 0x01);
  nrfWrite1Reg(REG_FEATURE, 0x00);             // No dynamic size payload
  nrfWrite1Reg(REG_DYNPD, 0x00);
  nrfWrite1Reg(REG_RX_PW_P0, 13);              //13 bytes payload
  nrfWrite1Reg(REG_EN_AA, 0);                  //Disable shockburst
}

//FIXME: A lot of parameters shall be configurable
static void eskylinkDecode(char* packet)
{
  static CRTPPacket crtpPacket;
  float pitch, roll, yaw;
  uint16_t thrust;
  
  pitch = ((packet[2]<<8) | packet[3])-PPM_ZERO;
  if (roll<(-PPM_RANGE)) roll = -PPM_RANGE;
  if (roll>PPM_RANGE) roll = PPM_RANGE;
  pitch *= 20.0/PPM_RANGE;
  
  roll = ((packet[0]<<8) | packet[1])-PPM_ZERO;
  if (roll<(-PPM_RANGE)) roll = -PPM_RANGE;
  if (roll>PPM_RANGE) roll = PPM_RANGE;
  roll *= 20.0/PPM_RANGE;
  
  yaw = ((packet[6]<<8) | packet[7])-PPM_ZERO;
  if (yaw<(-PPM_RANGE)) yaw = -PPM_RANGE;
  if (yaw>PPM_RANGE) yaw = PPM_RANGE;
  yaw *= 200.0/PPM_RANGE;
  
  thrust = ((packet[4]<<8) | packet[5])-PPM_MIN;
  if ((int16_t)thrust<0) thrust = (uint16_t)0;
  if (thrust>(2*PPM_RANGE)) thrust = 2*PPM_RANGE;
  thrust *= 55000/(2*PPM_RANGE);
  
  crtpPacket.port = CRTP_PORT_COMMANDER;
  memcpy(&crtpPacket.data[0],  (char*)&roll,   4);
  memcpy(&crtpPacket.data[4],  (char*)&pitch,  4);
  memcpy(&crtpPacket.data[8],  (char*)&yaw,    4);
  memcpy(&crtpPacket.data[12], (char*)&thrust, 2);
  
  xQueueSend(rxQueue, &crtpPacket, 0);
}

static void eskylinkTask(void * arg)
{
  int channel = 7;
  int channel1 = -1; //As long as channel1<0 the copter is in scann mode
  int channel2 = 0;

  //Waiting for pairing packet
  while (!state.paired)
  {
    xSemaphoreTake(dataRdy, portMAX_DELAY);
    ledseqRun(LED_GREEN, seq_linkup);
    
    eskylinkFetchData(packet, 13);

    if (packet[4]==0x18 && packet[5]==0x29)
    {
      address[2]=packet[0];
      address[1]=packet[1];
      address[0]=packet[2];
      state.band = packet[3];
      state.paired = true;
    }
  }

  ledseqRun(LED_GREEN, seq_testPassed);

  nrfSetEnable(false);
  eskylinkInitPaired(channel);
  nrfSetEnable(true);

  //Paired! handling packets.
  while(1)
  {
    if (xSemaphoreTake(dataRdy, M2T(10))==pdTRUE)
    {
      ledseqRun(LED_GREEN, seq_linkup);
    
      eskylinkFetchData(packet, 13);
      eskylinkDecode(packet);
      
      if (channel1<0) //Channels found!
      {
        channel1 = channel;
        channel2 = channel1+37;
        if (channel2>83) channel2 = channel1 - 37;
      }
    }
    else
    { 
      if (channel1<0)
      {
        channel++;
        if(channel>83) channel=7;
        nrfSetEnable(false);
        nrfSetChannel(channel);
        nrfSetEnable(true);
      }
      else
      {
        if (channel == channel1)
          channel = channel2;
        else
          channel = channel1;
        
        nrfSetEnable(false);
        nrfSetChannel(channel);
        nrfSetEnable(true);
      }
      
    }
  }
}

/*
 * Public functions
 */

void eskylinkInit()
{
  if(isInit)
    return;

  nrfInit();

  nrfSetInterruptCallback(interruptCallback);

  //vTaskSetApplicationTaskTag(0, (void*)TASK_RADIO_ID_NBR);

  /* Initialise the semaphores */
  vSemaphoreCreateBinary(dataRdy);

  /* Queue init */
  rxQueue = xQueueCreate(3, sizeof(CRTPPacket));

  eskylinkInitPairing();

    /* Launch the Radio link task */
  xTaskCreate(eskylinkTask, (const signed char *)"EskyLink",
              configMINIMAL_STACK_SIZE, NULL, /*priority*/1, NULL);

  isInit = true;
}

bool eskylinkTest()
{
  return nrfTest();
}

struct crtpLinkOperations * eskylinkGetLink()
{
  return &eskyOp;
}

//FIXME: To implement!
void eskylinkReInit(void)
{
  ;
}
