PJayChen/Crazyflies/4x_app_crazyflie_rel_a/modules/src/param.c

/**
 *    ||          ____  _ __
 * +------+      / __ )(_) /_______________ _____  ___
 * | 0xBC |     / __  / / __/ ___/ ___/ __ `/_  / / _ \
 * +------+    / /_/ / / /_/ /__/ /  / /_/ / / /_/  __/
 *  ||  ||    /_____/_/\__/\___/_/   \__,_/ /___/\___/
 *
 * Crazyflie control firmware
 *
 * Copyright (C) 2011-2012 Bitcraze AB
 *
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
 * param.h - Crazy parameter system source file.
 */
#include <string.h>
#include <errno.h>

/* FreeRtos includes */
#include "FreeRTOS.h"
#include "task.h"

#include "config.h"
#include "crtp.h"
#include "param.h"
#include "crc.h"
#include "console.h"

#include "sensfusion6.h"
#include "imu.h"
#include "controller.h"
#include "system.h"

paramsvar paramsint;

#define ENOENT 2 /* No such file or directory */


#define TOC_CH 0
#define READ_CH 1
#define WRITE_CH 2

#define CMD_RESET 0
#define CMD_GET_NEXT 1
#define CMD_GET_CRC 2

#define CMD_GET_ITEM 0
#define CMD_GET_INFO 1

//Private functions
static void paramTask(void * prm);
void paramTOCProcess(int command);


//These are set by the Linker  原代码定义，在链接文件中定义
//extern struct param_s _param_start;
//extern struct param_s _param_stop;

//The following two function SHALL NOT be called outside paramTask!
static void paramWriteProcess(int id, void*);
static void paramReadProcess(int id);
static int variableGetIndex(int id);

//Pointer to the parameters list and length of it
struct param_s * params;
static int paramsLen;
static uint32_t paramsCrc;
static int paramsCount = 0;

static bool isInit = false;

void paramInit(void)
{
  int i;

  if(isInit)
    return;
	paramsenserinit(&paramsint);
	paramsimuinit(&paramsint);
	paramscontrinit(&paramsint);
	paramscpuinit(&paramsint);

  params = (struct param_s *)&paramsint;
  paramsLen = (int)&paramsint.params_imu_acc_lpf[2].address - (int)&paramsint.params_sensorfusion6[0].type;
  paramsCrc = crcSlow(params, paramsLen);
  
  for (i=0; i<paramsLen; i++)
  {
    if(!(params[i].type & PARAM_GROUP)) 
      paramsCount++;
  }
  
  
  //Start the param task
	xTaskCreate(paramTask, "PARAM",
				    configMINIMAL_STACK_SIZE, NULL, /*priority*/1, NULL);
  
  //TODO: Handle stored parameters!
  
  isInit = true;
}

bool paramTest(void)
{
  return isInit;
}

CRTPPacket p;

void paramTask(void * prm)
{
	crtpInitTaskQueue(CRTP_PORT_PARAM);
	
	while(1) {
		crtpReceivePacketBlock(CRTP_PORT_PARAM, &p);
		
		if (p.channel==TOC_CH)
		  paramTOCProcess(p.data[0]);
	  else if (p.channel==READ_CH)
		  paramReadProcess(p.data[0]);
		else if (p.channel==WRITE_CH)
		  paramWriteProcess(p.data[0], &p.data[1]);
	}
}

void paramTOCProcess(int command)
{
  int ptr = 0;
  char * group = "";
  int n=0;
  
  switch (command)
  {
  case CMD_GET_INFO: //Get info packet about the param implementation
    ptr = 0;
    group = "";
    p.header=CRTP_HEADER(CRTP_PORT_PARAM, TOC_CH);
    p.size=6;
    p.data[0]=CMD_GET_INFO;
    p.data[1]=paramsCount;
    memcpy(&p.data[2], &paramsCrc, 4);
    crtpSendPacket(&p);
    break;
  case CMD_GET_ITEM:  //Get param variable
    for (ptr=0; ptr<paramsLen; ptr++) //Ptr points a group
    {
      if (params[ptr].type & PARAM_GROUP)
      {
        if (params[ptr].type & PARAM_START)
          group = params[ptr].name;
        else
          group = "";
      }
      else                          //Ptr points a variable
      {
        if (n==p.data[1])
          break;
        n++;
      }
    }
    
    if (ptr<paramsLen)
    {
      p.header=CRTP_HEADER(CRTP_PORT_PARAM, TOC_CH);
      p.data[0]=CMD_GET_ITEM;
      p.data[1]=n;
      p.data[2]=params[ptr].type;
      memcpy(p.data+3, group, strlen(group)+1);
      memcpy(p.data+3+strlen(group)+1, params[ptr].name, strlen(params[ptr].name)+1);
      p.size=3+2+strlen(group)+strlen(params[ptr].name);
      crtpSendPacket(&p);      
    } else {
      p.header=CRTP_HEADER(CRTP_PORT_PARAM, TOC_CH);
      p.data[0]=CMD_GET_ITEM;
      p.size=1;
      crtpSendPacket(&p);
    }
    break;
  }
}

static void paramWriteProcess(int ident, void* valptr)
{
  int id;

  id = variableGetIndex(ident);
  
  if (id<0) {
    p.data[0] = (uint8_t)-1;
    p.data[1] = ident;
    p.data[2] = ENOENT;
    p.size = 3;
    
    crtpSendPacket(&p);
    return;
  }

	if (params[id].type & PARAM_RONLY)
		return;

  switch (params[id].type & PARAM_BYTES_MASK)
  {
 	case PARAM_1BYTE:
 		*(uint8_t*)params[id].address = *(uint8_t*)valptr;
 		break;
    case PARAM_2BYTES:
  	  *(uint16_t*)params[id].address = *(uint16_t*)valptr;
      break;
 	case PARAM_4BYTES:
      *(uint32_t*)params[id].address = *(uint32_t*)valptr;
      break;
 	case PARAM_8BYTES:
      *(uint64_t*)params[id].address = *(uint64_t*)valptr;
      break;
  }
  
  crtpSendPacket(&p);
}

static void paramReadProcess(int ident)
{
  ////////////////////////////////////////////////////////////////////////////
	p.header = 0x14;
	memcpy(&p.data[0], params[1].address, sizeof(uint32_t));
	memcpy(&p.data[4], params[2].address, sizeof(uint32_t));
	memcpy(&p.data[8], params[3].address, sizeof(uint32_t));
	memcpy(&p.data[12], params[4].address, sizeof(uint32_t));
	p.size = 17;
	////////////////////////////////////////////////////////////////////////////
	/**************************************************************************
	int id;

  id = variableGetIndex(ident);
  
  if (id<0) {
    p.data[0] = (uint8_t)-1;
    p.data[1] = ident;
    p.data[2] = ENOENT;
    p.size = 3;
    
    crtpSendPacket(&p);
    return;
  }

  switch (params[id].type & PARAM_BYTES_MASK)
  {
 	case PARAM_1BYTE:
   		memcpy(&p.data[1], params[id].address, sizeof(uint8_t));
   		p.size = 1+sizeof(uint8_t);
   		break;
    case PARAM_2BYTES:
   		memcpy(&p.data[1], params[id].address, sizeof(uint16_t));
   		p.size = 1+sizeof(uint16_t);
   		break;
    case PARAM_4BYTES:
      memcpy(&p.data[1], params[id].address, sizeof(uint32_t));
   		p.size = 1+sizeof(uint32_t);
   		break;
 	  case PARAM_8BYTES:
      memcpy(&p.data[1], params[id].address, sizeof(uint64_t));
   		p.size = 1+sizeof(uint64_t);
   		break;
  }
  ******************************************************************************/
	
  crtpSendPacket(&p);
}

static int variableGetIndex(int id)
{
  int i;
  int n=0;
  
  for (i=0; i<paramsLen; i++)
  {
    if(!(params[i].type & PARAM_GROUP)) 
    {
      if(n==id)
        break;
      n++;
    }
  }
  
  if (i>=paramsLen)
    return -1;
  
  return i;
}
