PJayChen/Crazyflies/4x_app_crazyflie_rel_a/drivers/interface/ms5611.h

/**
 *    ||          ____  _ __
 * +------+      / __ )(_) /_______________ _____  ___
 * | 0xBC |     / __  / / __/ ___/ ___/ __ `/_  / / _ \
 * +------+    / /_/ / / /_/ /__/ /  / /_/ / / /_/  __/
 *  ||  ||    /_____/_/\__/\___/_/   \__,_/ /___/\___/
 *
 * Crazyflie Firmware
 *
 * Copyright (C) 2011 Fabio Varesano <fvaresano@yahoo.it>
 * Copyright (C) 2011-2012 Bitcraze AB
 *
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
 * @file ms5611.h
 * Driver for the ms5611 pressure sensor from measurement specialties.
 * Datasheet at http://www.meas-spec.com/downloads/MS5611-01BA03.pdf
 *
 */
#ifndef MS5611_H
#define MS5611_H

#include <stdbool.h>
#include <stdint.h>
#include "stm32f10x.h"



// addresses of the device
#define MS5611_ADDR_CSB_HIGH  0x76   //CBR=1 0x76 I2C address when CSB is connected to HIGH (VCC)
#define MS5611_ADDR_CSB_LOW   0x77   //CBR=0 0x77 I2C address when CSB is connected to LOW (GND)

// registers of the device
#define MS5611_D1 0x40
#define MS5611_D2 0x50
#define MS5611_RESET 0x1E

// D1 and D2 result size (bytes)
#define MS5611_D1D2_SIZE 3

// OSR (Over Sampling Ratio) constants
#define MS5611_OSR_256 0x00
#define MS5611_OSR_512 0x02
#define MS5611_OSR_1024 0x04
#define MS5611_OSR_2048 0x06
#define MS5611_OSR_4096 0x08

#define MS5611_PROM_BASE_ADDR 0xA2 // by adding ints from 0 to 6 we can read all the prom configuration values.
// C1 will be at 0xA2 and all the subsequent are multiples of 2
#define MS5611_PROM_REG_COUNT 6 // number of registers in the PROM
#define MS5611_PROM_REG_SIZE 2 // size in bytes of a prom registry.

// Self test parameters. Only checks that values are sane
#define MS5611_ST_PRESS_MAX   (1100.0) //mbar
#define MS5611_ST_PRESS_MIN   (450.0)  //mbar
#define MS5611_ST_TEMP_MAX    (60.0)   //degree celcius
#define MS5611_ST_TEMP_MIN    (-20.0)  //degree celcius


bool ms5611Init(I2C_TypeDef *i2cPort);
bool ms5611SelfTest(void);
bool ms5611EvaluateSelfTest(float min, float max, float value, char* string);
float ms5611GetPressure(uint8_t osr);
float ms5611CalcPressure(int32_t rawPress, int32_t dT);
float ms5611GetTemperature(uint8_t osr);
float ms5611CalcTemp(int32_t deltaT);
int32_t ms5611GetDeltaTemp(uint8_t osr);
int32_t ms5611CalcDeltaTemp(int32_t rawTemp);
int32_t ms5611RawPressure(uint8_t osr);
int32_t ms5611RawTemperature(uint8_t osr);
bool ms5611ReadPROM(void);
void ms5611Reset(void);
void ms5611StartConversion(uint8_t command);
int32_t ms5611GetConversion(uint8_t command);

#endif // MS5611_H
