PJayChen/Crazyflies/4x_app_crazyflie_rel_a/hal/src/radiolink.c

/*
 *    ||          ____  _ __                           
 * +------+      / __ )(_) /_______________ _____  ___ 
 * | 0xBC |     / __  / / __/ ___/ ___/ __ `/_  / / _ \
 * +------+    / /_/ / / /_/ /__/ /  / /_/ / / /_/  __/
 *  ||  ||    /_____/_/\__/\___/_/   \__,_/ /___/\___/
 *
 * Crazyflie control firmware
 *
 * Copyright (C) 2012 BitCraze AB
 *
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
 * radiolink.c: nRF24L01 implementation of the CRTP link
 */

#include <stdbool.h>
#include <errno.h>

#include "nrf24l01.h"
#include "crtp.h"
#include "configblock.h"
#include "ledseq.h"

#include "FreeRTOS.h"
#include "task.h"
#include "queue.h"
#include "semphr.h"

#define ENETDOWN 100 /* Network is down */

static bool isInit;

/* Synchronisation */
xSemaphoreHandle dataRdy;
/* Data queue */
xQueueHandle txQueue;
xQueueHandle rxQueue;

//Union used to efficiently handle the packets (Private type)
typedef union
{
  CRTPPacket crtp;
  struct {
    uint8_t size;
    uint8_t data[32];
  } __attribute__((packed)) raw;
} RadioPacket;

static struct {
  bool enabled;
} state;

static void interruptCallback()
{
  portBASE_TYPE  xHigherPriorityTaskWoken = pdFALSE;

  //To unlock RadioTask
  xSemaphoreGiveFromISR(dataRdy, &xHigherPriorityTaskWoken);

  if(xHigherPriorityTaskWoken)
  	portYIELD();
//    vPortYieldFromISR();
}

// 'Class' functions, called from callbacks
static int setEnable(bool enable)
{
  nrfSetEnable(enable);
  state.enabled = enable;

  return 0;
}

static int sendPacket(CRTPPacket * pk)
{
  if (!state.enabled)
    return ENETDOWN;
  
  xQueueSend( txQueue, pk, portMAX_DELAY);
  
  return 0;
}

static int receivePacket(CRTPPacket * pk)
{
  if (!state.enabled)
    return ENETDOWN;

  xQueueReceive( rxQueue, pk, portMAX_DELAY);

  return 0;
}

static struct crtpLinkOperations radioOp =
{
  .setEnable         = setEnable,
  .sendPacket        = sendPacket,
  .receivePacket     = receivePacket,
};

/* Radio task handles the CRTP packet transfers as well as the radio link
 * specific communications (eg. Scann and ID ports, communication error handling
 * and so much other cool things that I don't have time for it ...)
 */
static void radiolinkTask(void * arg)
{
  unsigned char dataLen;
  static RadioPacket pk;

  //Packets handling loop
  while(1)
  {
    ledseqRun(LED_GREEN, seq_linkup);

    xSemaphoreTake(dataRdy, portMAX_DELAY);
    
    nrfSetEnable(false);
    
    //Fetch all the data (Loop until the RX Fifo is NOT empty)
    while( !(nrfRead1Reg(REG_FIFO_STATUS)&0x01) )
    {
      dataLen = nrfRxLength(0);

      if (dataLen>32)          //If a packet has a wrong size it is dropped
        nrfFlushRx();
      else                     //Else, it is processed
      {
        //Fetch the data
        pk.raw.size = dataLen-1;
        nrfReadRX((char *)pk.raw.data, dataLen);

        //Push it in the queue (If overflow, the packet is dropped)
        if (!CRTP_IS_NULL_PACKET(pk.crtp))  //Don't follow the NULL packets
          xQueueSend( rxQueue, &pk, 0);
      }
    }

    //Push the data to send (Loop until the TX Fifo is full or there is no more data to send)
    while( (uxQueueMessagesWaiting((xQueueHandle)txQueue) > 0) && !(nrfRead1Reg(REG_FIFO_STATUS)&0x20) )
    {
      xQueueReceive(txQueue, &pk, 0);
      pk.raw.size++;

      nrfWriteAck(0, (char*) pk.raw.data, pk.raw.size);
    }

    //clear the interruptions flags
    nrfWrite1Reg(REG_STATUS, 0x70);
    
    //Re-enable the radio
    nrfSetEnable(true);
  }
}

static void radiolinkInitNRF24L01P(void)
{
  int i;
  char radioAddress[5] = {0xE7, 0xE7, 0xE7, 0xE7, 0xE7};

  //Set the radio channel
  nrfSetChannel(configblockGetRadioChannel());
  //Set the radio data rate
  nrfSetDatarate(configblockGetRadioSpeed());
  //Set radio address
  nrfSetAddress(0, radioAddress);

  //Power the radio, Enable the DS interruption, set the radio in PRX mode
  nrfWrite1Reg(REG_CONFIG, 0x3F);
  vTaskDelay(M2T(2)); //Wait for the chip to be ready
  // Enable the dynamic payload size and the ack payload for the pipe 0
  nrfWrite1Reg(REG_FEATURE, 0x06);
  nrfWrite1Reg(REG_DYNPD, 0x01);

  //Flush RX
  for(i=0;i<3;i++)
    nrfFlushRx();
  //Flush TX
  for(i=0;i<3;i++)
    nrfFlushTx();
}

/*
 * Public functions
 */

void radiolinkInit()
{
  if(isInit)
    return;

  nrfInit();

  nrfSetInterruptCallback(interruptCallback);

  vTaskSetApplicationTaskTag(0, (pdTASK_HOOK_CODE)TASK_RADIO_ID_NBR);

  /* Initialise the semaphores */
  vSemaphoreCreateBinary(dataRdy);

  /* Queue init */
  rxQueue = xQueueCreate(3, sizeof(RadioPacket));
  txQueue = xQueueCreate(3, sizeof(RadioPacket));

  radiolinkInitNRF24L01P();

    /* Launch the Radio link task */
  xTaskCreate(radiolinkTask, (const signed char *)"RadioLink",
              configMINIMAL_STACK_SIZE, NULL, /*priority*/1, NULL);

  isInit = true;
}

bool radiolinkTest()
{
  return nrfTest();
}

struct crtpLinkOperations * radiolinkGetLink()
{
  return &radioOp;
}

void radiolinkReInit(void)
{
  if (!isInit)
    return;

  radiolinkInitNRF24L01P();
}
