PJayChen/Crazyflies/4x_app_crazyflie_rel_a/modules/src/commander.c

/**
 *    ||          ____  _ __
 * +------+      / __ )(_) /_______________ _____  ___
 * | 0xBC |     / __  / / __/ ___/ ___/ __ `/_  / / _ \
 * +------+    / /_/ / / /_/ /__/ /  / /_/ / / /_/  __/
 *  ||  ||    /_____/_/\__/\___/_/   \__,_/ /___/\___/
 *
 * Crazyflie Firmware
 *
 * Copyright (C) 2011-2012 Bitcraze AB
 *
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
 *
 */
#include "stm32f10x_conf.h"

#include "FreeRTOS.h"
#include "task.h"

#include "commander.h"
#include "crtp.h"
#include "configblock.h"

#define MIN_THRUST  10000
#define MAX_THRUST  60000

struct CommanderCrtpValues
{
  float roll;
  float pitch;
  float yaw;
  uint16_t thrust;
} __attribute__((packed));

static struct CommanderCrtpValues targetVal[2];
static bool isInit;
static int side=0;
static uint32_t lastUpdate;
//static bool isInactive;

static void commanderCrtpCB(CRTPPacket* pk);
static void commanderWatchdog(void);
static void commanderWatchdogReset(void);

void commanderInit(void)
{
  if(isInit)
    return;

  crtpInit();
  crtpRegisterPortCB(CRTP_PORT_COMMANDER, commanderCrtpCB);

  lastUpdate = xTaskGetTickCount();
//  isInactive = TRUE;
  isInit = TRUE;
}

bool commanderTest(void)
{
  crtpTest();
  return isInit;
}

static void commanderCrtpCB(CRTPPacket* pk)
{
  targetVal[!side] = *((struct CommanderCrtpValues*)pk->data);
  side = !side;
  commanderWatchdogReset();
}

static void commanderWatchdog(void)
{
  int usedSide = side;
  uint32_t ticktimeSinceUpdate;

  ticktimeSinceUpdate = xTaskGetTickCount() - lastUpdate;

  if (ticktimeSinceUpdate > COMMANDER_WDT_TIMEOUT_STABALIZE)
  {
    targetVal[usedSide].roll = 0;
    targetVal[usedSide].pitch = 0;
    targetVal[usedSide].yaw = 0;
  }
  if (ticktimeSinceUpdate > COMMANDER_WDT_TIMEOUT_SHUTDOWN)
  {
    targetVal[usedSide].thrust = 0;
//    isInactive = TRUE;
  }
  else
  {
//    isInactive = FALSE;
  }
}

static void commanderWatchdogReset(void)
{
  lastUpdate = xTaskGetTickCount();
}

uint32_t commanderGetInactivityTime(void)
{
  return xTaskGetTickCount() - lastUpdate;
}

void commanderGetRPY(float* eulerRollDesired, float* eulerPitchDesired, float* eulerYawDesired)
{
  int usedSide = side;

  *eulerRollDesired  = targetVal[usedSide].roll;
  *eulerPitchDesired = targetVal[usedSide].pitch;
  *eulerYawDesired   = targetVal[usedSide].yaw;
}

void commanderGetRPYType(RPYType* rollType, RPYType* pitchType, RPYType* yawType)
{
  *rollType  = ANGLE;
  *pitchType = ANGLE;
  *yawType   = RATE;
}

void commanderGetTrust(uint16_t* thrust)
{
  int usedSide = side;
  uint16_t rawThrust = targetVal[usedSide].thrust;

  if (rawThrust > MIN_THRUST)
  {
    *thrust = rawThrust;
  }
  else
  {
    *thrust = 0;
  }

  if (rawThrust > MAX_THRUST)
  {
    *thrust = MAX_THRUST;
  }

  commanderWatchdog();
}
