PJayChen/Crazyflies/(notices)

Notices in the files:
4x_app_crazyflie_rel_a/modules/interface/pid.h:
This program is free software: you can redistribute it and/or modify
it under the terms of the GNU General Public License as published by
the Free Software Foundation, in version 3.
